bpaulina25/CBE3300B/Images/sd card.JPG

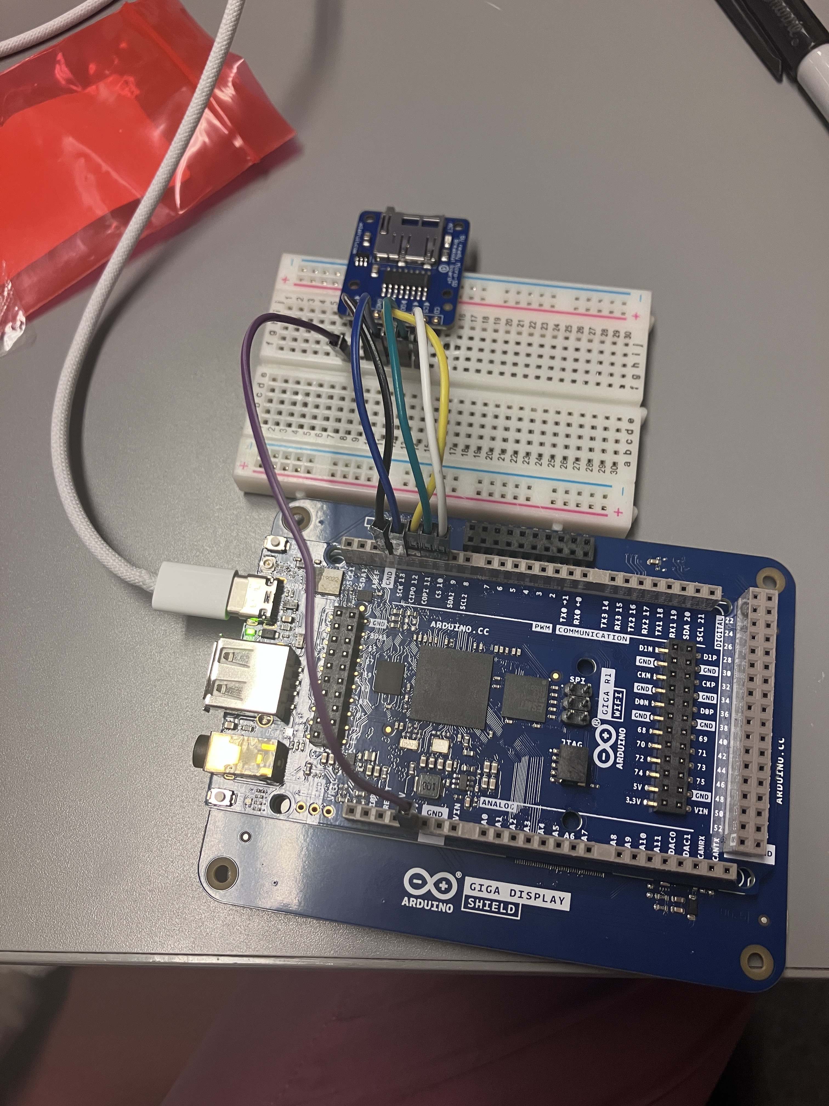
Images/sd card.JPG
