bpaulina25/CBE3300B/Images/io_rodeostat.png

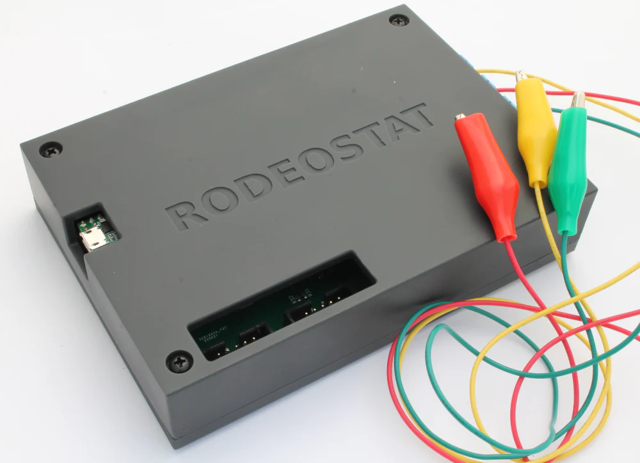
Images/io_rodeostat.png
