bpaulina25/CBE3300B/README.md

# CBE3300B
Glucometer Project with Paulina Bargallo, Kayla Powell and Theertha Vannemreddy
