bpaulina25/CBE3300B/proposal.html

Project Proposal: Potentiostat-Based Glucometer

Introduction

The increasing prevalence of diabetes necessitates the development of reliable, accessible, and accurate glucometers. Traditional glucometers utilize enzyme-modified electrodes for electrochemical glucose detection. This project aims to develop a low-cost, potentiostat-based glucometer prototype that employs cyclic voltammetry for glucose quantification. The system will be validated against standard glucose solutions to ensure accuracy and reproducibility, paving the way for further refinements in electrochemical biosensing technology.

Objectives

- Construct a potentiostat capable of performing cyclic voltammetry.
- Adapt the potentiostat for glucose detection using enzyme-modified electrodes.
- Validate the prototype by calibrating it with standard glucose solutions.
- Identify and address limitations to improve future iterations.

Materials and Components

Hardware:

- IO Rodeostat ($240, already purchased)
- Adapters from IO Rodeostat (https://blog.iorodeo.com/zp_hypervalue_rodeostat_adapter/) for screen-printed electrodes (optional, depending on AimsStrip compatibility)
- Power Supply (Compatible with Adafruit ItsyBitsy M4, (Adafruit board guide (https://www.adafruit.com/product/2124)))
  - Battery backpack (Adafruit LiIon/LiPoly Backpack (https://www.adafruit.com/product/2124)) can debug w/ USB connection switch to LiIon/LiPoly when disconnected
- Display Screen Options:
  - Arduino Display
    - Sold out in Arduino USA (https://store-usa.arduino.cc/products/giga-display-shield), but available in eBay (https://www.ebay.com/itm/156329309170?chn=ps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) for $55 and in Arduino Europe (https://store.arduino.cc/products/giga-display-shield)
    - This is the option we like the most, we hope to be able to not only store information and display date, time, user and previous readings as well as average of readings but to also control with it the whole device.
    - How to program GitHub page. (https://github.com/upiir/arduino_giga_display_shield)
  - Display compatible (https://www.adafruit.com/product/4200?ref=blog.iorodeo.com) with IO Rodeostat - $35
    - This is our second option, we like the availability of the buttons as we hope to do the same as with the Arduino Display, we want to make sure both are compatible with ItsyBitsy and it is on our level to program. Has been used before by IO Rodeo in a colorimeter product (https://blog.iorodeo.com/open-colorimeter-product-guide/), this are the electronics (https://blog.iorodeo.com/open-colorimeter-electronics/).
  - Adafruit Display (https://www.digikey.com/en/products/detail/adafruit-industries-llc/3531/7364307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)- $24, Uses Raspberry Pi
    - We are not sure we want to go this route so it is possible we do no longer consider it.
- Microcontroller: Adafruit ItsyBitsy M4 (https://www.adafruit.com/product/3800) ($15, consider purchasing three in case of failure)

Calibration and Testing:

- Glucose test strips (AimsStrip (https://www.germainelabs.com/product/aimstrip-plus-blood-glucose-test-strips-50-box/), Amazon (https://www.amazon.com/AimStrip-37350-Blood-Glucose-Strips/dp/B07J5P9GXG?s=industrial), $15.15 for 50 strips)
  - AimsStrip glucose test strips contain glucose oxidase, therefore we will be basing our reactions on this enzyme.
- d-Glucose stock solution (250 g/L in PBS)
- Phosphate-buffered saline (PBS) for dilutions
- Calibration concentrations: 10–200 mg/dL

Benchmark fasting blood glucose ranges:

- Normal: 70–100 mg/dL
- Low: <70 mg/dL
- High: >125 mg/dL

Software and Tools:

- Arduino IDE for waveform generation and data acquisition
- Processing script for real-time data visualization
- Excel/Matlab for calibration curve fitting and data analysis

Methodology

- Calibration:
  - Prepare glucose solutions (10–200 mg/dL) for calibration.
  - Conduct cyclic voltammetry scans, analyzing oxidation current peaks for correlation with glucose concentration.
  - Discard initial unstable scans and average subsequent scans for consistency.
- Testing and Validation:
  - Evaluate performance using glucose standards within physiologically relevant ranges.
  - Compare prototype readings to known glucose concentrations to assess accuracy and linearity.
  - Identify potential anomalies such as saturation at high concentrations and address underlying causes (e.g., mixing issues, electrode kinetics limitations).
- Data Analysis:
  - Generate calibration curves based on the Randles-Sevcik equation.
  - Analyze deviations at high glucose concentrations and adjust scan parameters accordingly.

Engineering Design Considerations

- Signal Stability: Noise reduction through optimized resistor selection and scan rates.
- User Interface: Develop an intuitive interface for user-friendly data retrieval and analysis.
- Power Supply: Assess battery-operated vs. external power options for portable use.

Concepts for Future Improvements

- Error Analysis: Improve accuracy by refining calibration and eliminating systematic biases.
- Data Storage and User Profiles: Implement onboard memory to track readings over time.
- Integration with Display Modules: Consider LCD or LED screens for real-time data visualization.

Minimum Viable Product (MVP)

- Functional potentiostat using IO Rodeostat.
- Basic glucose detection with standard calibration.
- Python-based data output (no external display required).
- Single-user operation without long-term data storage.
- Acceptable margin of error (15%) per industry standards.

Main Goals

- Develop a user-friendly glucose meter.
- Achieve industry-standard error margins.
- Optimize calibration to meet ISO specifications.
- Store and analyze user data for long-term tracking.
- Incorporate date/time functionality for better monitoring.

Engineering Design for a Glucose Meter

- Design Considerations: Designing a glucose meter from scratch requires attention to accuracy, durability, user-friendliness, and manufacturability. The device must reliably measure blood glucose levels while maintaining portability and ease of use for patients. Key design elements include:
  - Electrochemical Sensor Integration: Ensuring that the electrodes and sensor interface with the testing strip effectively.
  - Microcontroller & Signal Processing: Selecting a suitable microcontroller to process sensor data and display readings accurately.
  - User Interface & Display: Designing an intuitive LCD or OLED display for easy readability of results.
  - Power Efficiency: Optimizing battery life to allow prolonged usage without frequent recharging.
  - Button and Screen Design: Ensuring that the buttons are tactile, responsive, and easy to press. The screen should have a backlight for readability in low-light conditions and use a high-contrast display to accommodate users with visual impairments
  - Test Strip Insertion Space: Designing a dedicated, easy-to-access slot for test strips that aligns properly with the sensor to ensure accurate readings. The space should be durable, resistant to contamination, and facilitate effortless insertion and removal of strips.
- Material Selection:
  - Housing Material: The enclosure must be lightweight, durable, and resistant to chemical exposure. Common materials include:
    - ABS Plastic: Offers strength, impact resistance, and ease of manufacturing.
    - Polycarbonate (PC): Provides excellent optical clarity for display covers and high impact resistance.
    - Medical-Grade Silicone: Used for areas requiring flexibility and skin contact.
    - Sensor Material: Electrodes are typically made from gold, platinum, or carbon-based materials to ensure accurate glucose readings.
    - Transparent Cover: If an optical component is used, acrylic or
- 3D Printing Considerations:To prototype and manufacture certain components, 3D printing is a cost-effective and efficient approach. Considerations include:
  - Printing Technology:
  - Fused Deposition Modeling (FDM): Suitable for quick and low-cost prototyping using PLA or ABS.
  - Stereolithography (SLA): Provides high precision and smooth surfaces, ideal for detailed housing parts.
- Material Compatibility:
  - PLA: Easy to print but lacks high durability. (This is what we use in CBE lab)
  - Resin (SLA): High precision but more fragile than thermoplastics. (Can use FormLabs Printers in Towne or Biotech Commons)
- Structural Integrity:
  - Wall thickness should be optimized to balance durability and weight.
  - Snap-fit or screw-based designs should be tested for assembly efficiency. (Still debating which would be the best).
- Surface Finishing:
  - Smoothing processes like acetone vapor treatment (for ABS) or UV curing (for SLA) improve aesthetic and functional properties.s.

Prototyping and Testing

- Drop and Stress Testing: Ensures durability for everyday use.
- Chemical Resistance Testing: Verifies material stability against blood and cleaning agents.
- User Ergonomics Evaluation: Assesses handling ease, readability, and button placement.

Review of glucometer electrochemical reactions

Glucose monitoring devices are currently dominated by electrochemically mediated analytical techniques. The main governing reaction in glucose concentration determination is the aerobic oxidation of glucose, shown below. The chemistry involved is the oxidation of glucose via the enzyme glucose oxidase (GOx) to produce glucono-d-lactone (GNL). The dissolved oxygen re-oxidizes the enzyme, producing hydrogen peroxide in molar equivalence.

α-D-glucose⇌β-D-glucose (1)

β-D-glucose+O2→GOx

\text{H}_{2}\text{O}_{2} + \text{GNL} (2)

H2O2 --> 2H+ + O2 + 2e- (3)

O2 + 4e- --> 2O2- (4)

A relatively high stock concentration (250 g/L) of b-D-glucose in PBS will be used for preparing dilutions of experimental blood serum simulant. If preparation of fresh glucose is needed, time for anomeric equilibrium be taken into account (1), as glucose oxidase (GOx) is only active on the b-D glucose conformation (2). Otherwise measurements will not be reliable due to fluctuating b-D-glucose concentration.

As shown in (2), the amount of dissolved molecular oxygen present and H2O2 produced is in molar equivalence with the glucose, and electroanalytical methods can be employed to measure the current generated at the electrode and determine glucose concentration in whole blood/blood serum.

H2O2 is an electrochemically active species, and is oxidized on the test strip (usually a Pt anode) in the form of (3). Monitoring the amount of oxygen consumed via Clark electrodes (4) can also allow for glucose concentration determination using selective oxygen reduction.

These preceding reactions represent the enzyme interactions of first-generation blood sugar test strips. However, the limitations of this approach are mainly due to oxygen’s poor performance as an electron acceptor due to its reduced solubility of oxygen in blood and susceptibility to oxygen deficit [add link]. Additionally, measurement of H2O2 concentration via amperometric methods tended to require high operating potentials for sufficient selectivity [add link]. Thus, mediator ions were integrated into second-generation glucose biosensors to more accurately measure glucose concentration-dependent current generation. A proposed mechanism is seen below [add link]:

Fe(III)cat-GOxRED + (5)

In these test strips, the enzyme is re-oxidized by the mediator. Then, the mediator reagent is re-oxidized at the anode surface, generating an electrical current proportional to the concentration of glucose. Ferrous compounds like ferrocenes and ferricyanide are a common selection due to high stability in both oxidized and reduced states.

The test strips (AimStrip Plus Mini) used in our system are second-generation glucose biosensors that use potassium ferricyanide as the mediator, according to the SDS [add link]. Therefore, determination of electrode-type is not needed and amperometric analysis for the ferri/ferrocyanide couple can be implemented in our glucometer.

Chronoamperometry:

In chronoamperometry, a step potential is applied to induce the Faradaic electron transfer that can be characterized by existing equations for diffusion controlled current generation. Prior to step potential, the potential of WE is held as a value that produces no faradaic electron transfers. Then a sufficiently lower/higher potential is applied to produce the desired reduction/oxidation of the target species.

The Cottrell equation, below, will be used to construct the glucometer calibration curve between current and glucose concentration.

i = (6)

In the case of ferri/ferrocyanide (assuming sat'd Ag/AgCl RE), the minimum step potential can be estimated from available data. The equilibrium potential for the RE vs. SHE is +0.197 V [link] and for ferri/ferrocyanide it is +0.356 V [link]. It follows that E = + 0.356 V - 0.197 V to give an estimated 160 mV as the expected step potential minimum. This will need to be experimentally confirmed.

Trials will be conducted over a range of step potential values to assess a suitable positive applied potential to generate a diffusion controlled current (on an i vs t1/2 plot, according to (6)). Calculations can be done to determine an upper limit to the step potential to avoid interference from other oxidizable species in the analyte. Lag time will also need to be experimentally determined to avoid initial double layer charging not modeled in (6).

The glucometer will apply the step potential and record the relevant current value, apply the calibration equation, and output the generated glucose concentration calculation.

Current market glucometer product design features:

Typical features of glucometers currently available include, but are not limited to, the following:

Copy over list

Preliminary firmware development:

- 1. Power on/off buttons and time-out response
- 2. CA analyte detection/initiation
- 3. Memory - Date/Time syncing and daily averaging or ~100 past readings storage
- 4. Display configuration

This project provides a foundation for developing a practical, low-cost glucometer with future scalability for enhanced features such as wireless data transfer and cloud integration. The prototype will be iteratively improved based on testing outcomes and user feedback to meet clinical standards.
