bpaulina25/CBE3300B/Presentations/Potentiostat-Based Glucometer Proposal.pdf

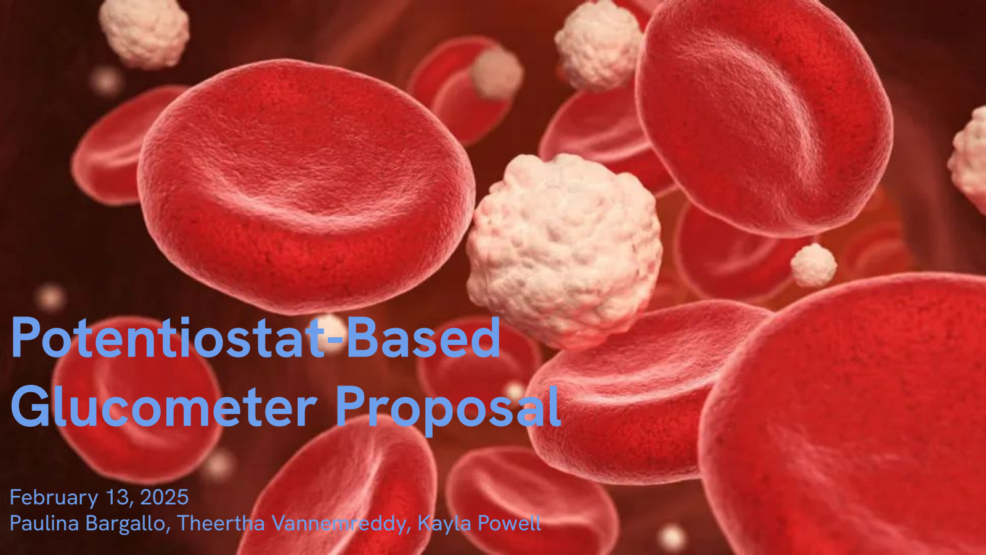
[picture p3: page 1]

# Potentiostat-Based Glucometer Proposal

## February 13, 2025 Paulina Bargallo, Theertha Vannemreddy, Kayla Powell

Overview

The increasing prevalence of diabetes necessitates the development of reliable, accessible, and accurate glucometers. This project aims to develop a low-cost, potentiostat-based glucometer prototype that employs amperometry for glucose quantification. The system will be validated against standard glucose solutions to ensure accuracy and reproducibility, paving the way for further refinements in electrochemical biosensing

technology.

# Project Overview

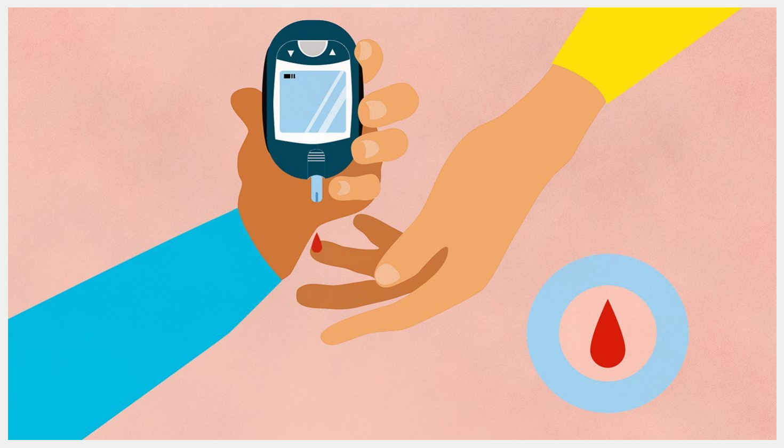
[picture p4: figure]

# Project Objectives

Objectives

Design an easy-to-use, durable, portable glucometer.

Ensure compatibility between all components through various prototyping stages.

Development of sufficient redox-mediated calibration between glucose concentration and electrochemically produced measurement appropriate for instrumentation.

Final product performs similarly compared to current available second generation glucometer.

Calibration

Hardware
development

User-friendly
design

Experimental
validation

01

02

03

04

# Working Schedule

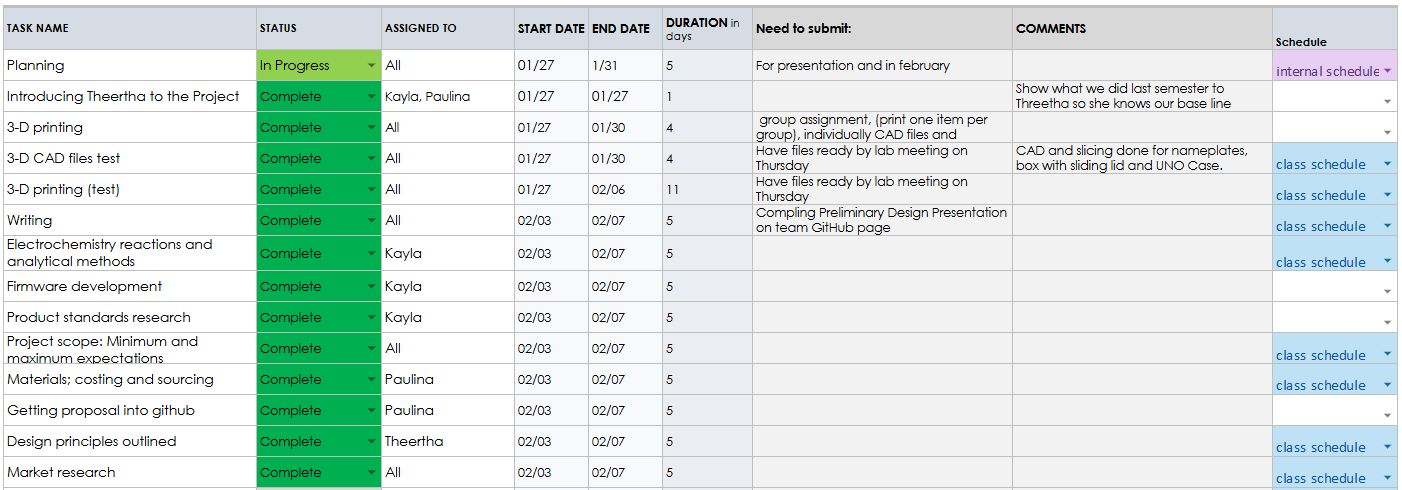
[picture p5: figure]

# Materials and Components

Proposal

### - AimsStrip Plus Mini glucose test strips ($15.15 for 50 strips)

### - d-Glucose stock solution (250 g/L in PBS)

### - PBS for dilution preparation

### - IO Rodeostat

### - Accompanying Adafruit ItsyBitsy Board (MC)

### - Electrode wire connector (adjusted for test strips) and shim

### - Adafruit Li Battery Backpack

### - Arduino Display (available on eBay for $55)

### - IO Rodeostat-compatible display ($35)

### - Adafruit Display ($24)

Calibration and Testing | Hardware Components | Display Screen Options

### Purchased, Needs to be purchased

Sold out in: Arduino USA, (https://store-usa.arduino.cc/products/giga-display-shield)
Available: in eBay (https://www.ebay.com/itm/156329309170?chn=ps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) for $55 In Arduino Europe (https://store.arduino.cc/products/giga-display-shield)

## Arduino Display

# TO BUY (please & Thank you) :

Adafruit | ItsyBitsy | M4 (https://www.adafruit.com/product/3800) | - | $15,
purchasing 2

## Microcontroller

AimsStrip, (https://www.germainelabs.com/product/aimstrip-plus-blood-glucose-test-strips-50-box/) Amazon, (https://www.amazon.com/AimStrip-37350-Blood-Glucose-Strips/dp/B07J5P9GXG?s=industrial) $15.15 for 50 strips

(as many as possible Dr. Huff can by for us at once)

## Glucose Test Strip

## PBS

For this experiment so we do not use CBE 4800.

## Battery Backpack

Adafruit LiIon/LiPoly Backpack (https://www.adafruit.com/product/2124)

$4.80 (buy 3)

# AimStrip Plus Glucose Meter

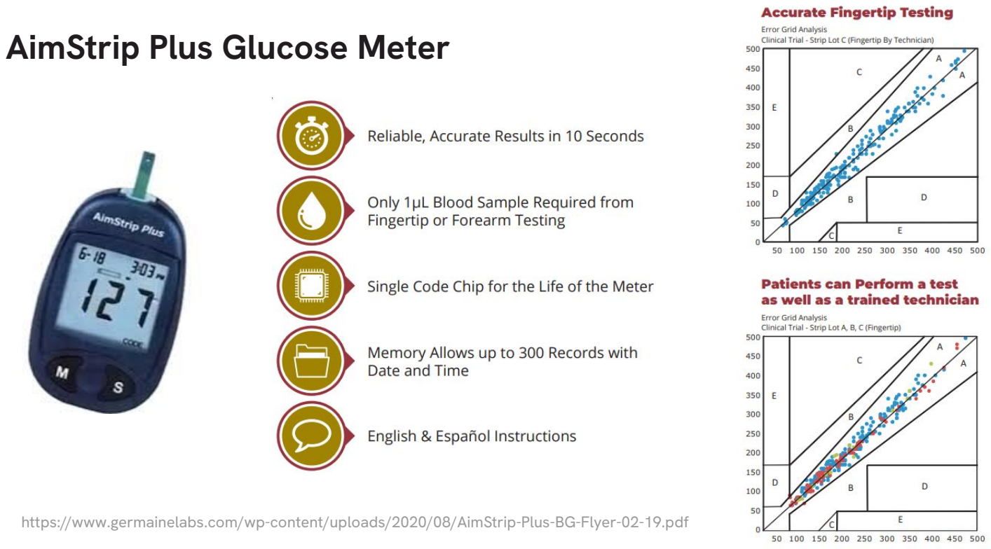
[picture p6: page 7]

https://www.germainelabs.com/wp-content/uploads/2020/08/AimStrip-Plus-BG-Flyer-02-19.pdf

### - Primary reaction is aerobic oxidation of glucose with glucose oxidase (GOx)

### - Redox-mediated electron transfer introduced to improve efficiency, accuracy

### - AimStrip Plus Strips

– | GOx/FAD
– | Ferri/ferrocyanide mediator
– | 10 sec response time

# Electrochemical Reactions in Glucometers

Chemistry

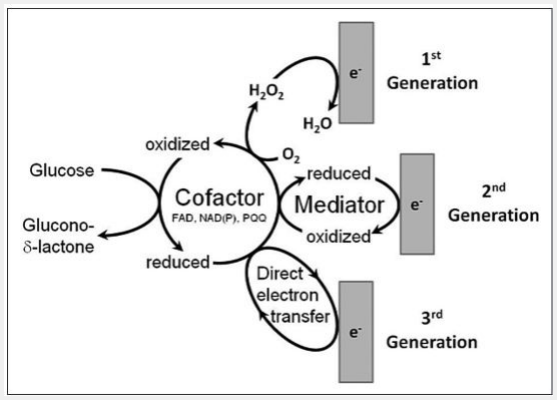
[picture p7: figure]

https://doi.org/10.1177/193229681100500507

# Analytical Methods

Chemistry

### - Amperometric analysis

### - Experimentally determine

### – Appropriate step potential for selective oxidation of Fe(II) back to Fe(III)

### – Lag time (steady-state)

### - Get linear calibration between current and concentration from Cottrell equation:

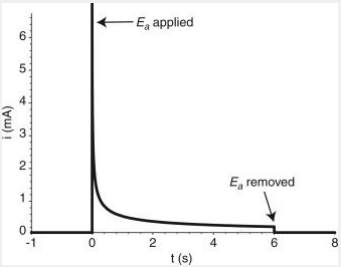
[picture p8: figure]

https://doi.org/10.1016/B978-0-12-802993-0.00004-6

# Engineering Design Considerations

Design

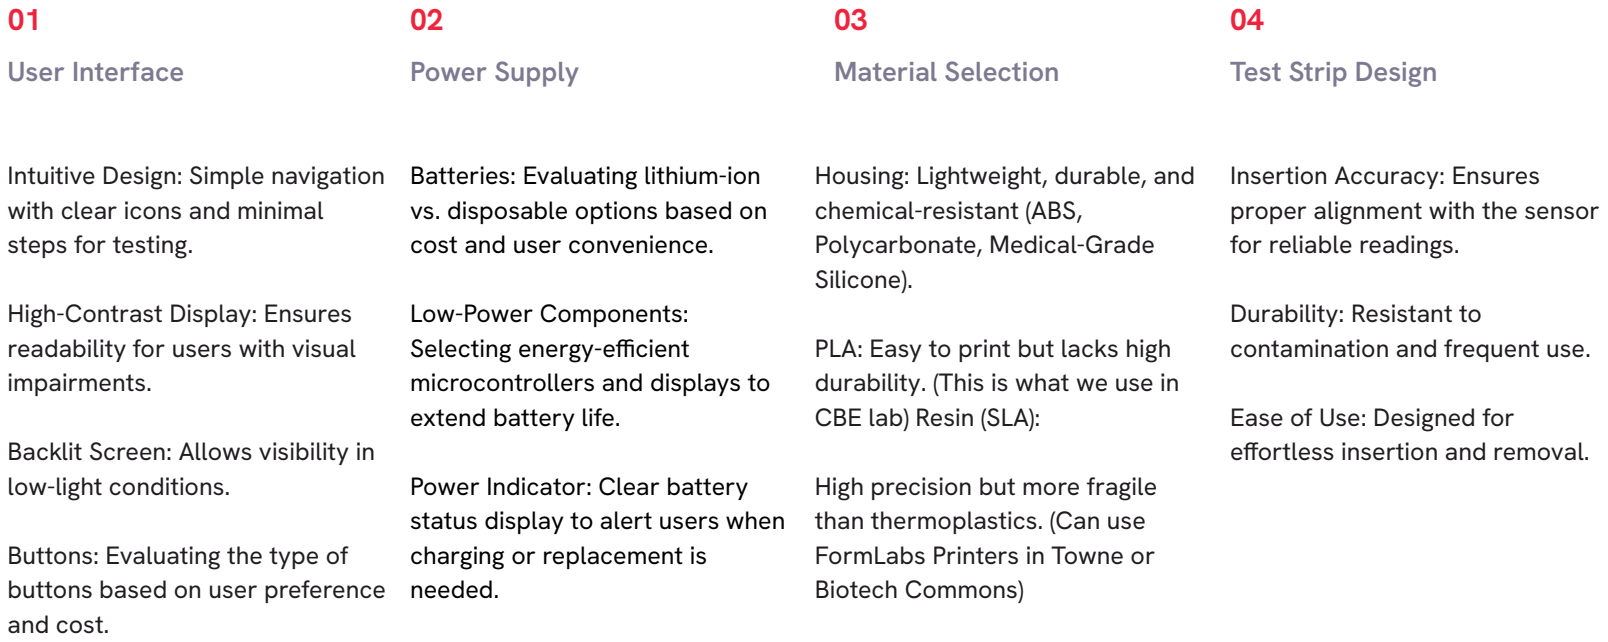
[picture p9: figure]
Intuitive Design: Simple navigation with clear icons and minimal steps for testing.; High-Contrast Display: Ensures readability for users with visual impairments.; Backlit Screen: Allows visibility in low-light conditions.; Buttons: Evaluating the type of buttons based on user preference and cost.; Batteries: Evaluating lithium-ion vs. disposable options based on cost and user convenience.; Low-Power Components: Selecting energy-efficient microcontrollers and displays to extend battery life.; Power Indicator: Clear battery status display to alert users when charging or replacement is needed.; User Interface; Power Supply; Housing: Lightweight, durable, and chemical-resistant (ABS, Polycarbonate, Medical-Grade Silicone).; PLA: Easy to print but lacks high durability. (This is what we use in CBE lab) Resin (SLA):; High precision but more fragile than thermoplastics. (Can use FormLabs Printers in Towne or Biotech Commons); Material Selection; Insertion Accuracy: Ensures proper alignment with the sensor for reliable readings.; Durability: Resistant to contamination and frequent use.; Ease of Use: Designed for effortless insertion and removal.; Test Strip Design

### 3D Printing

# Prototyping and Testing

Engineering Design

Material Testing | Chemical Resistance Testing | User Ergonomics Evaluation

Utilize fused deposition
modeling (FDM) for quick and low-cost prototyping using PLA or ABS materials. This approach allows for rapid iterations in design before final production.
Conduct drop and stress testing to ensure durability for everyday use. The goal is to verify that the device withstands typical handling and potential impacts. | Verify the material stability against blood and cleaning agents. This ensures that the device remains functional and safe for users in real-world scenarios. | Assess handling ease, readability, and button placement to ensure the glucometer is user-friendly and accessible, particularly for users with visual impairments.

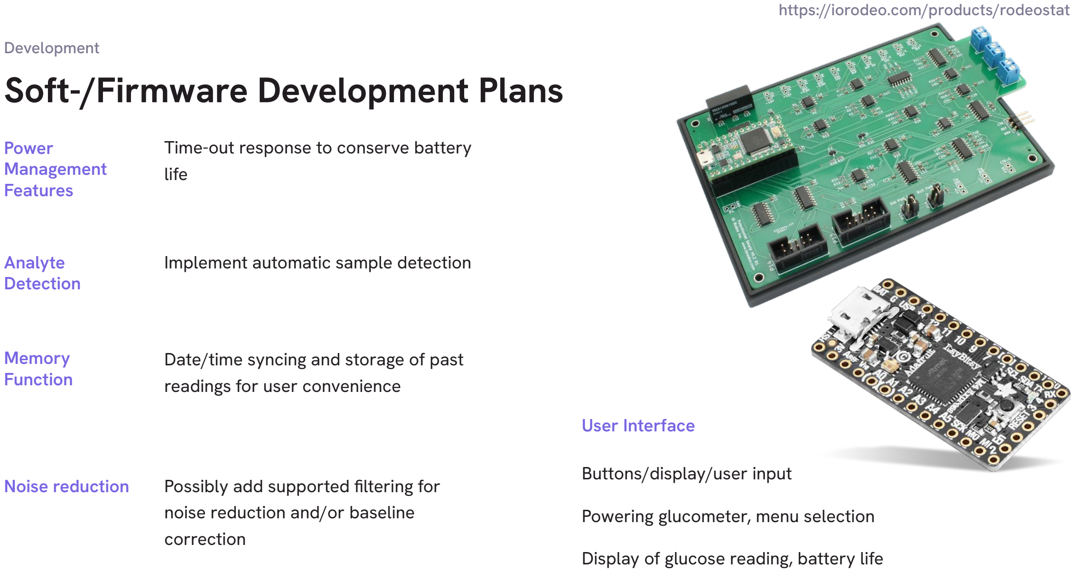
[picture p10: figure]
Soft-/Firmware Development Plans; Development; Time-out response to conserve battery life; Implement automatic sample detection; Power Management Features; Analyte Detection; Memory Function; Date/time syncing and storage of past readings for user convenience; Noise reduction; User Interface; Possibly add supported filtering for noise reduction and/or baseline correction; Buttons/display/user input; Powering glucometer, menu selection; https://iorodeo.com/products/rodeostat

Display of glucose reading, battery life

### - Functional potentiostat

using IO Rodeostat.

### - Basic glucose detection

with standard calibration.

### - Python-based data output (no external display

required).

### - Single-user operation without long-term data

storage.

### - Acceptable margin of error

### - User-friendly design and ISO-approved accuracy - Store and analyze user

data for long-term tracking.

### - Incorporate date/time functionality for better

monitoring.

### - Portable and durable design

Minimum Viable Product | Main Goals

# Project Scope

### - Product build - Test strip connection to potentiostat

### - Durability

### - Calibration - Large error - Batch-to-batch test strip inconsistencies

### - Firmware integration - User-friendly interface

## Expected Challenges

Summary

# Conclusion and Next Steps

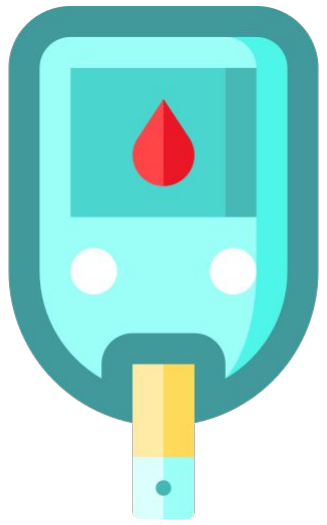
[picture p11: figure]

## Develop a user-friendly, low-cost, amperometric-based glucometer to enhance ease of glucose monitoring for

individuals with diabetes.

## Next steps include:

## - Familiarization with IO Rodeostat and completed calibration function - Design parts purchases - Outline for prototype-circuit and continued research into circuit design

# Thank you! Questions?

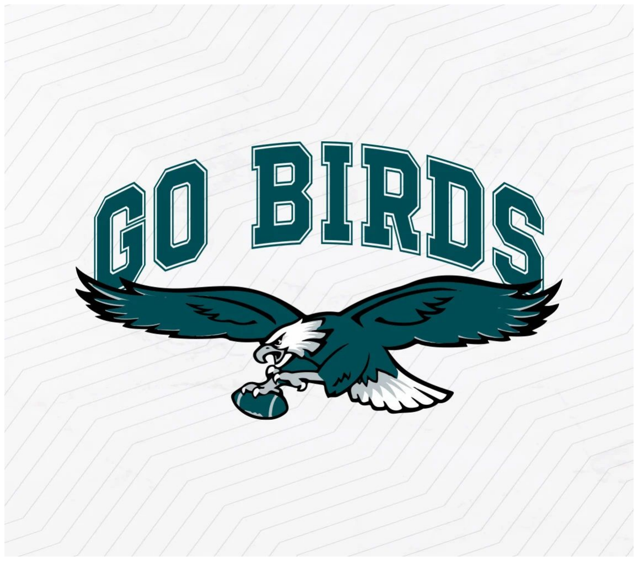
[picture p12: figure]
