bpaulina25/CBE3300B/Presentations/SweeTech_ Glucometer_Development Plan.pdf

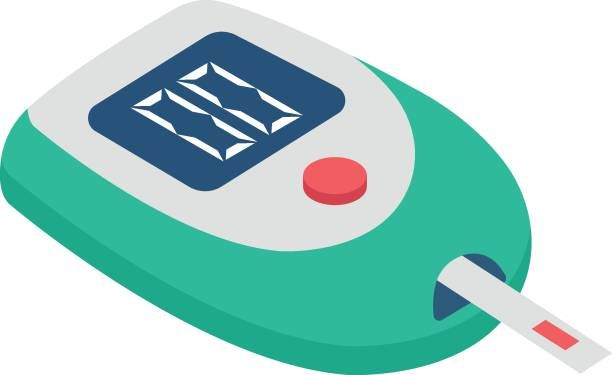
[picture p13: figure]

SweeTech

# Glucometer Development

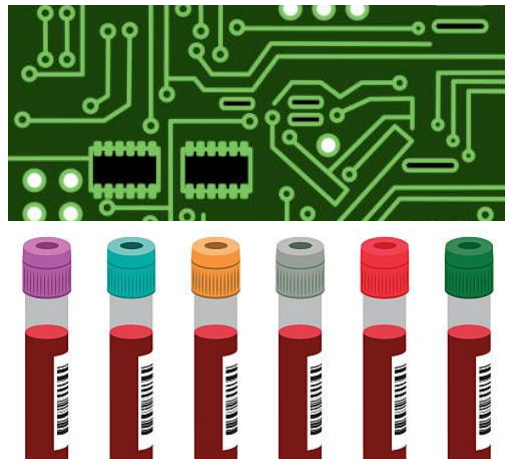
[picture p14: figure]

# Plan

Contributor
Kayla Powell, Paulina Bargallo, Theertha Vannemreddy

# How do glucometers work?

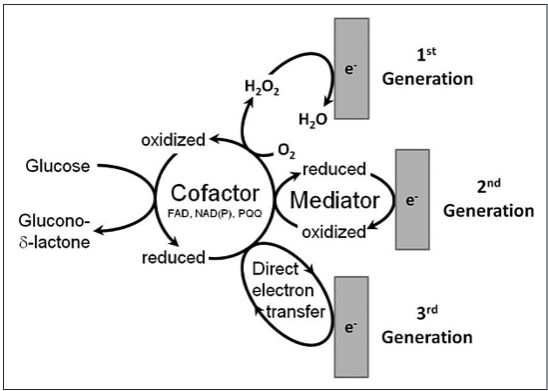
[picture p15: figure]

- Electrochemical reactions occur on biosensor
- Glucose oxidase (GOx) is most common enzyme
- Primary reaction is aerobic oxidation of glucose with GOx/FAD
– O2

electron acceptor
– Concentration determined via O2 consumption or H2O2

generation
– Challenges: O2

mass transfer limitations
and high overpotentials
- Redox-mediated electron transfer introduced to improve efficiency, accuracy
- Advancements in nanotechnology allow for direct electron transfer to support continuous glucose level monitoring

# AimStrip® Plus Glucose Meter and Strips

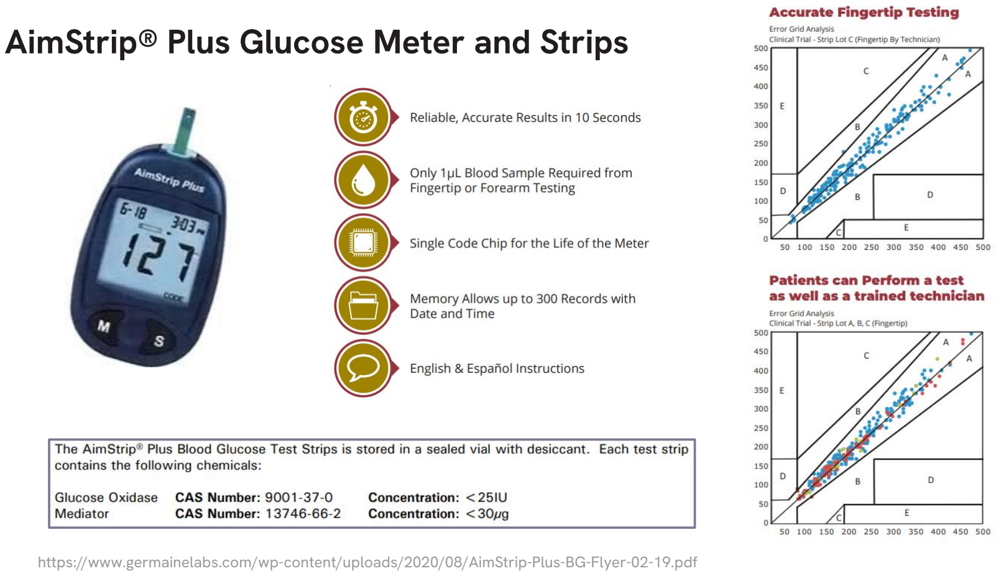
[picture p16: page 3]

https://www.germainelabs.com/wp-content/uploads/2020/08/AimStrip-Plus-BG-Flyer-02-19.pdf

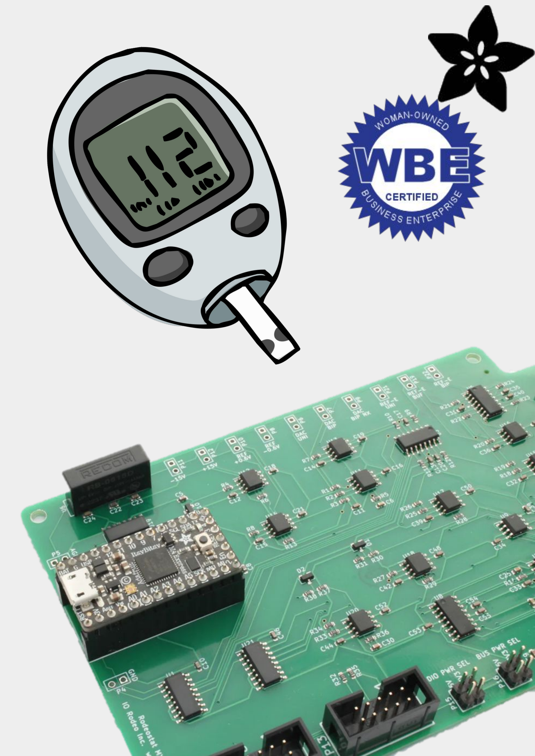
[picture p17: figure]

# Our glucometer design

- IO Rodeostat supported amperometry
– Digitally-controlled
– Selective oxidation of mediator for calibration
- Hardware selection
– Adafruit ItsyBitsy M4 MCU
- Internal and serial flash memory
- Supports python + USB debugging
- 12-bit ADC and general in/output pins
– Arduino GIGA Display Shield/R1 WiFi
- High resolution and touch-screen function
- SPI communication with board
- Python support for integration
- 3D printing
– Biosensor connection
– Sturdy design for practical use and secure integration of components

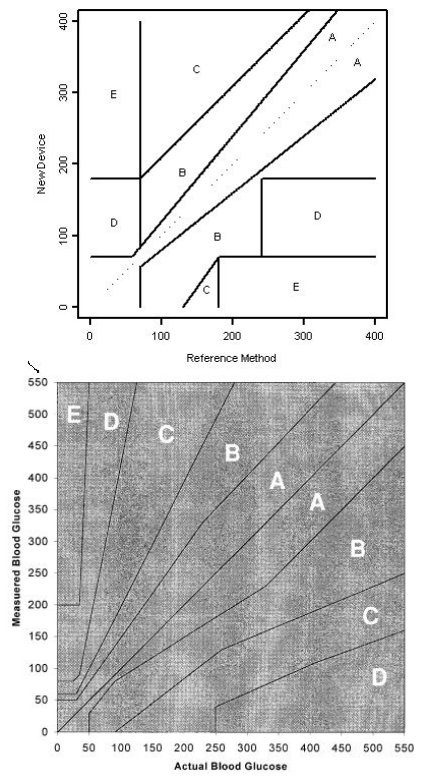
[picture p18: figure]

# Accuracy standards

- ISO 15197:2013 (user performance evaluation for 95% of samples) – <100 mg/dL: ± 15 mg/dL
– ≥100 mg/dL: ± 15% error
- Error grids (right)
– Clarke Error Grid (top)
– Consensus Error Grid for Type II diabetes (bottom)
- Advanced grid following the development of glucose monitoring devices
- FDA/EU requirements
- WHO recommendations
– Testing range of 30-400 mg/dL
– ISO compliance
– 99% results fall within zones A/B of Consensus Error Grid – Technical and performance specifications are detailed (https://www.who.int/publications/m/item/who-technical-specifications-for-blood-glucose-meter) for enzymatic with amperometric detection formats

# Diabetes and glucose monitoring market trends

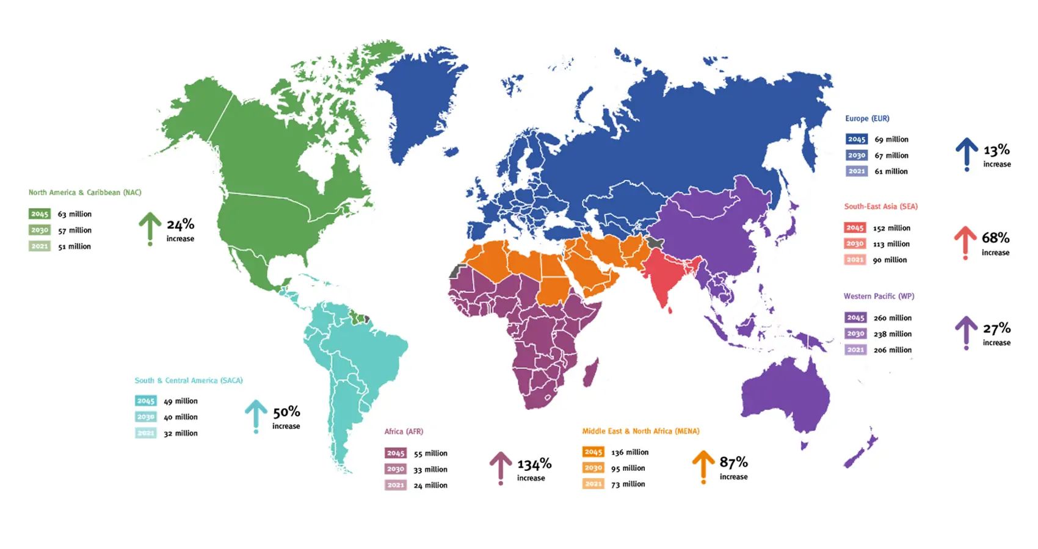
[picture p19: figure]

# Diabetes and glucose monitoring market trends

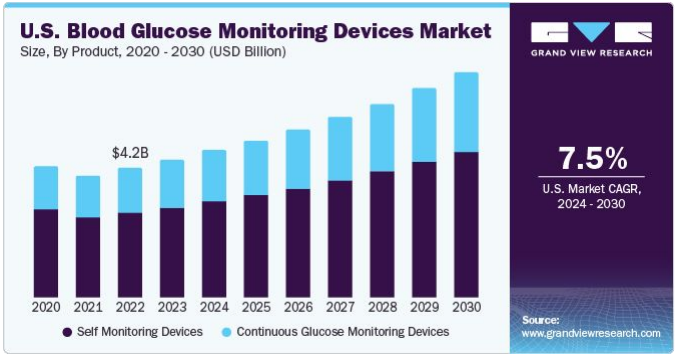
[picture p20: figure]

# Diabetes and glucose monitoring market trends

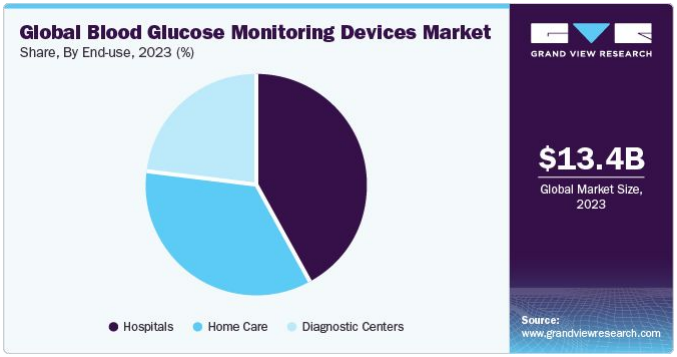
[picture p21: figure]

# Competitive evaluation

- Key features of industry self-monitoring devices – $20-100 per glucometer
– Portable and compact
– Some devices have continuous monitoring.
– Most of cost is test strip (glucometers often included for free) – Waterproof
- Features of SweeTech glucometer
– $240 potentiostat
– $137 display components
– Much more sophisticated potentiostat than is needed for glucometer function – Not commercially competitive; better for learning and research purposes
– Not portable due to large size. Not compact
– Does not have live monitoring features.

## SWOT analysis

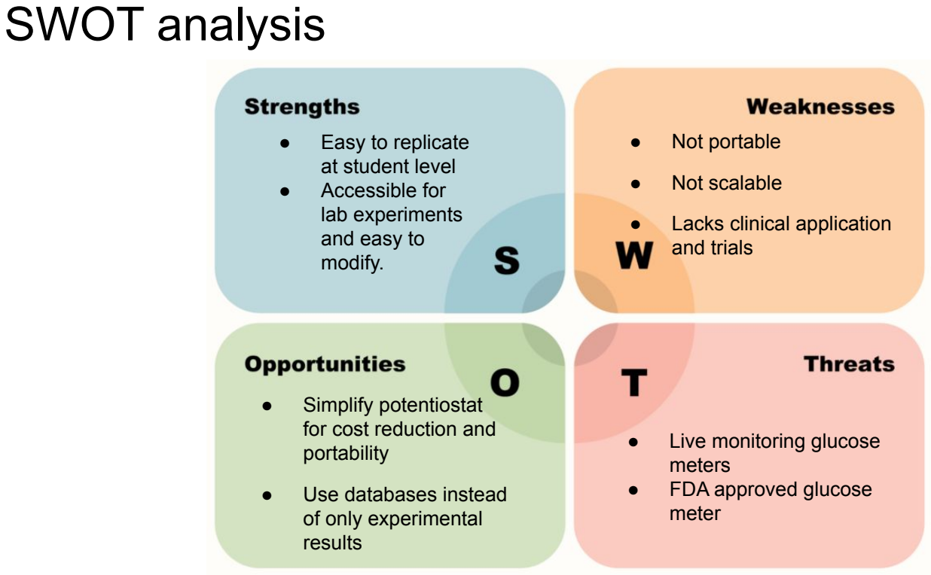
[picture p22: page 10]

- Easy to replicate
at student level
- Accessible for
lab experiments
and easy to
modify.
- Not portable
- Not scalable
- Lacks clinical application and trials
- Simplify potentiostat
for cost reduction and
portability
- Use databases instead
of only experimental
results
- Live monitoring glucose
meters
- FDA approved glucose
meter

## Project timeline and deliverables

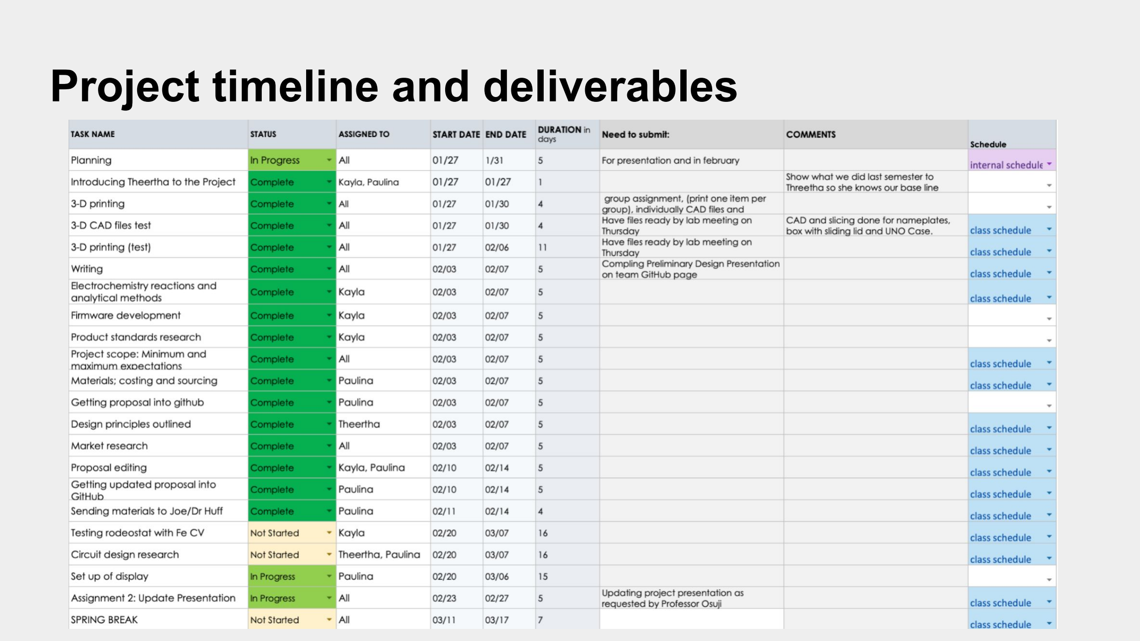
[picture p23: page 11]
