bpaulina25/CBE3300B/final_resources/Final_Demo_Glucometer.pdf

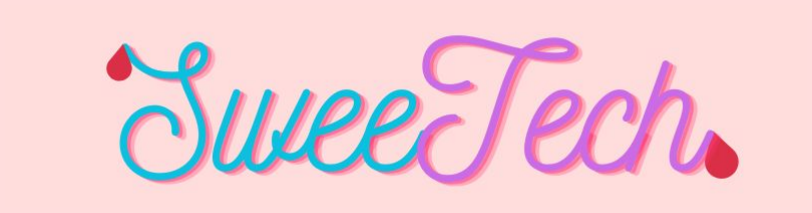
[picture p24: figure]

## Potentiostat-based Glucometer Development

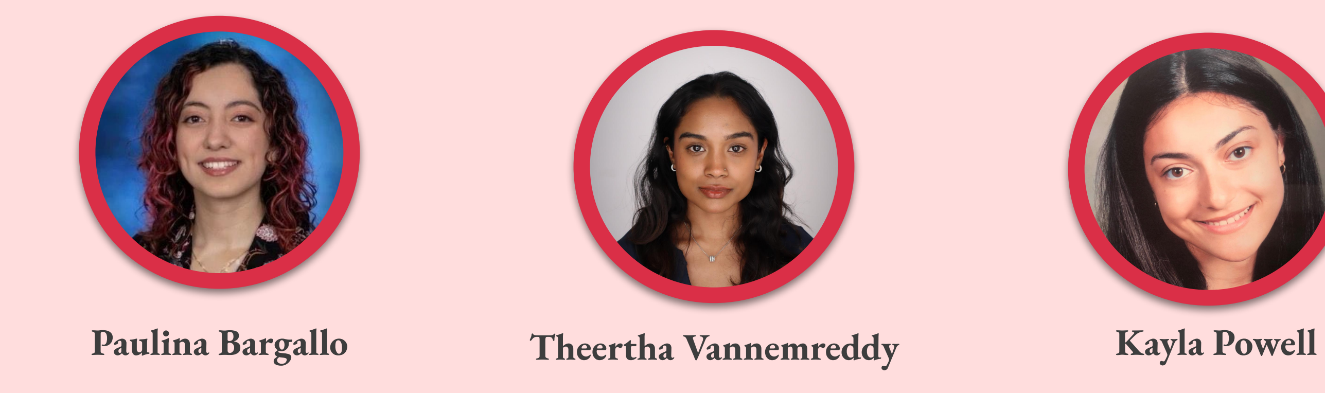
[picture p25: figure]
Paulina Bargallo; Theertha Vannemreddy; Kayla Powell
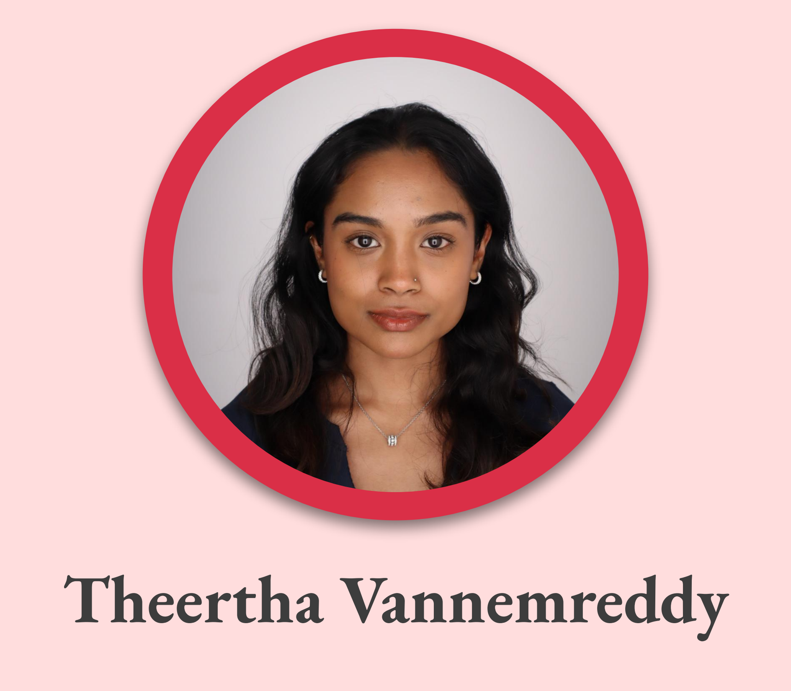
[picture p26: figure]
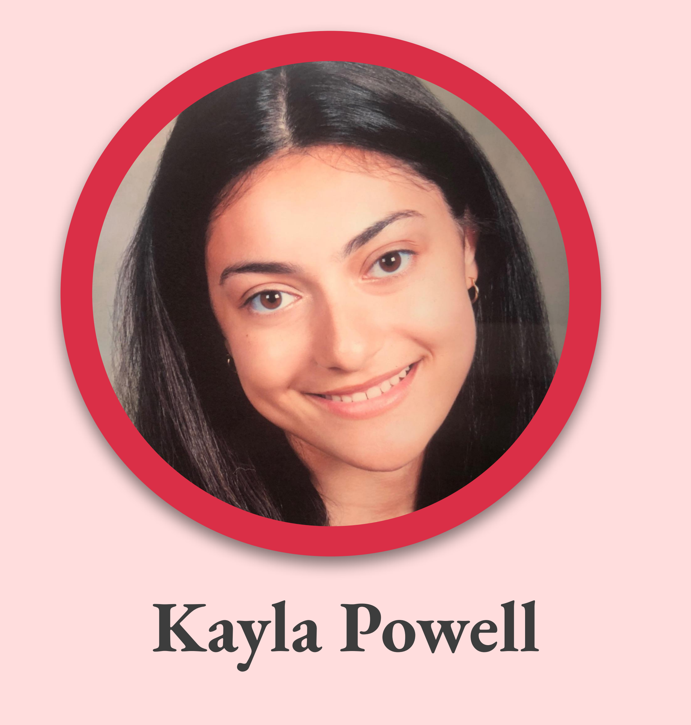
[picture p27: figure]

## CBE 3300 - Final Demonstration May 7th, 2025

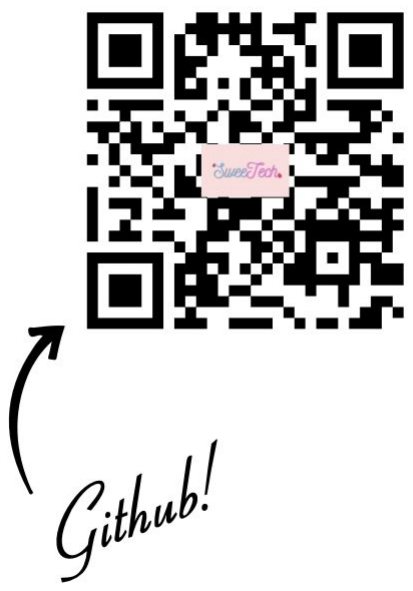
[picture p28: figure]

2

# Github Page

# Project Overview

With diabetes on the rise, this project develops a potentiostat-based glucometer using amperometry for glucose detection.

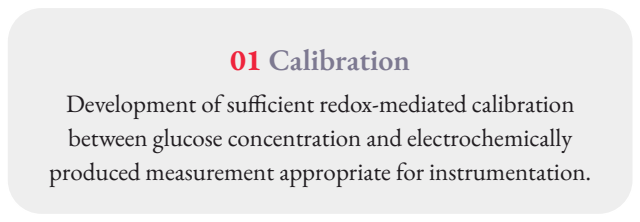
[picture p29: figure]
01 Calibration; Development of sufficient redox-mediated calibration between glucose concentration and electrochemically produced measurement appropriate for instrumentation.
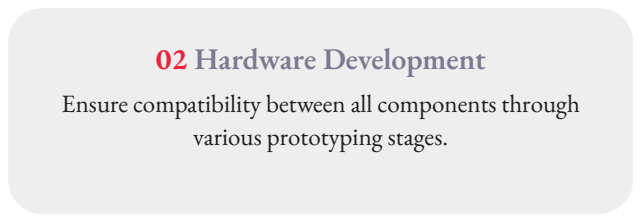
[picture p30: figure]
02 Hardware Development; various prototyping stages.

Ensure compatibility between all components through

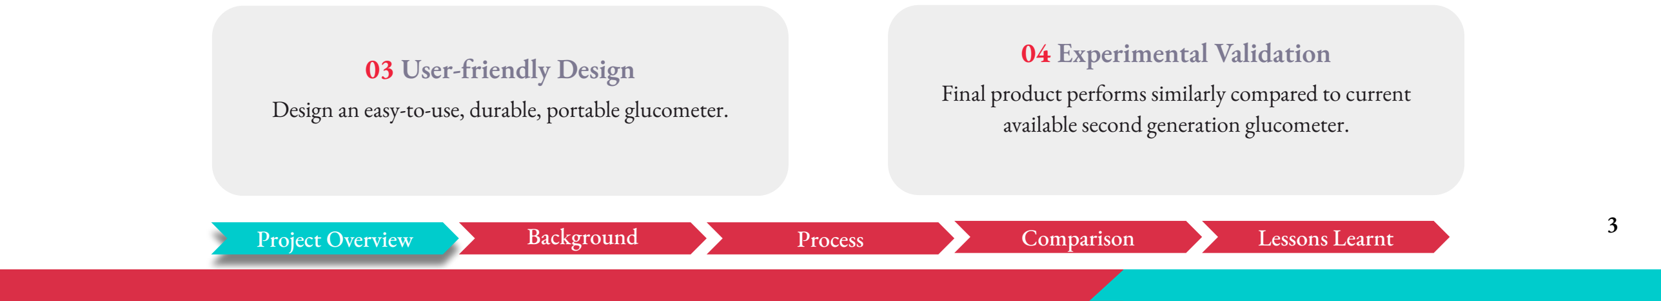
[picture p31: figure]
Project Overview; Background; Process; Comparison; Lessons Learnt; 03 User-friendly Design; 04 Experimental Validation; available second generation glucometer.

Design an easy-to-use, durable, portable glucometer.

Final product performs similarly compared to current

# Our Background

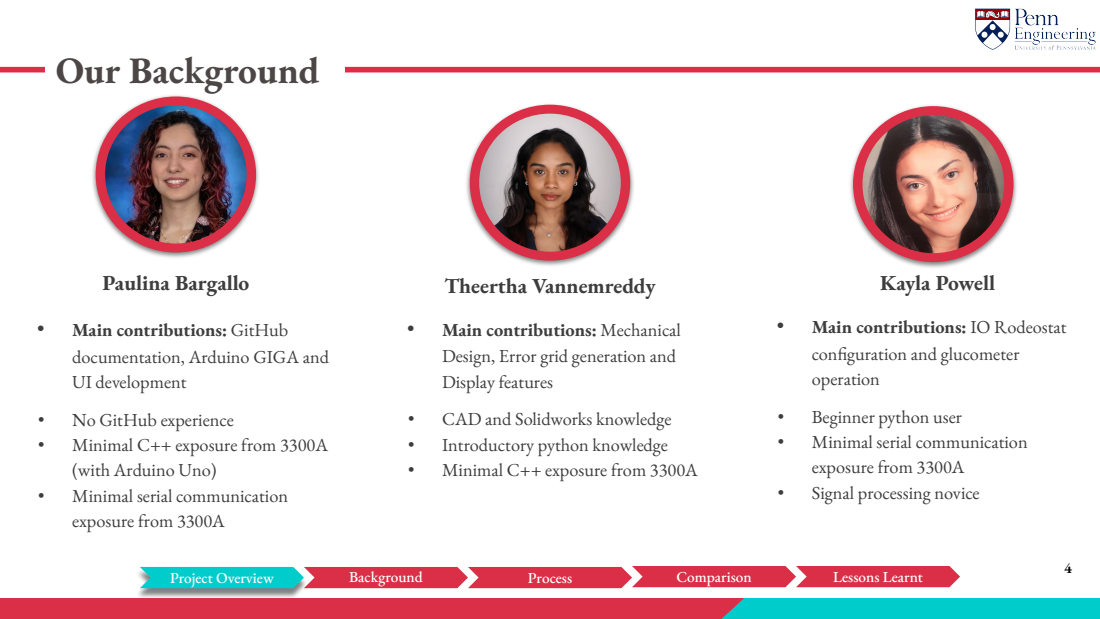
[picture p32: page 4]
Project Overview; Background; Process; Comparison; Lessons Learnt; Paulina Bargallo; Theertha Vannemreddy; Kayla Powell

• Main contributions: GitHub
documentation, Arduino GIGA and
UI development
• No GitHub experience
• Minimal C++ exposure from 3300A
(with Arduino Uno)
• Minimal serial communication
exposure from 3300A

• Main contributions: Mechanical
Design, Error grid generation and
Display features
• CAD and Solidworks knowledge
• Introductory python knowledge

• Main contributions: IO Rodeostat
configuration and glucometer
operation
• Beginner python user
• Signal processing novice

5

Project Overview | Background | Process | Comparison | Lessons Learnt

# Background

# Market Landscape

537M

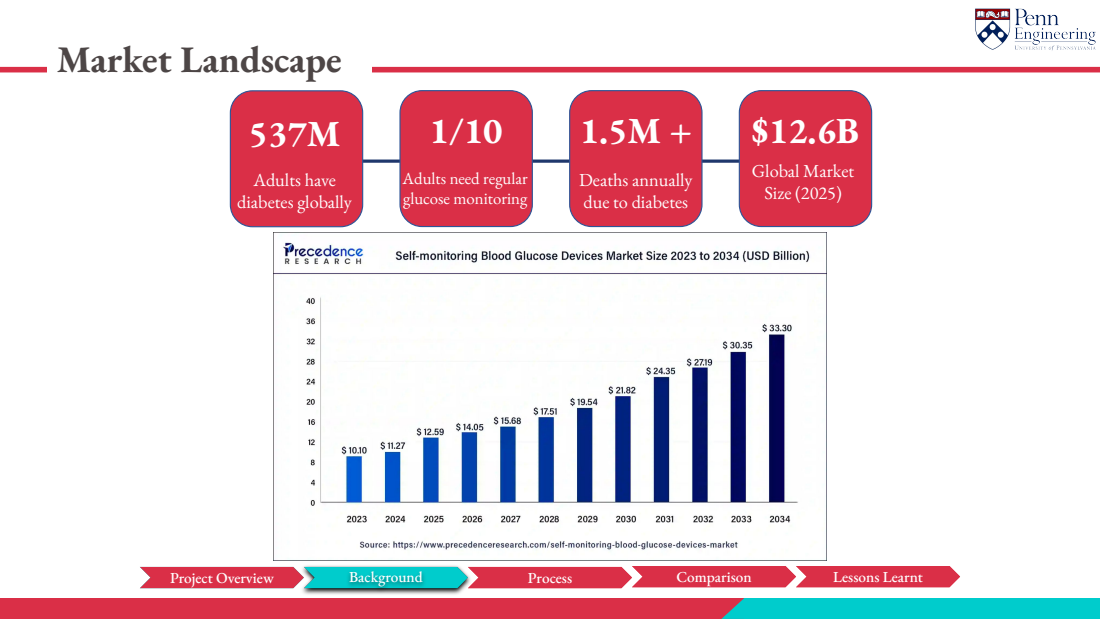
[picture p33: page 6]
Adults have diabetes globally; Global Market Size (2025); Project Overview; Background; Process; Comparison; Lessons Learnt

Adults need regular
glucose monitoring

Deaths annually
due to diabetes

# Global glucose monitoring market trends

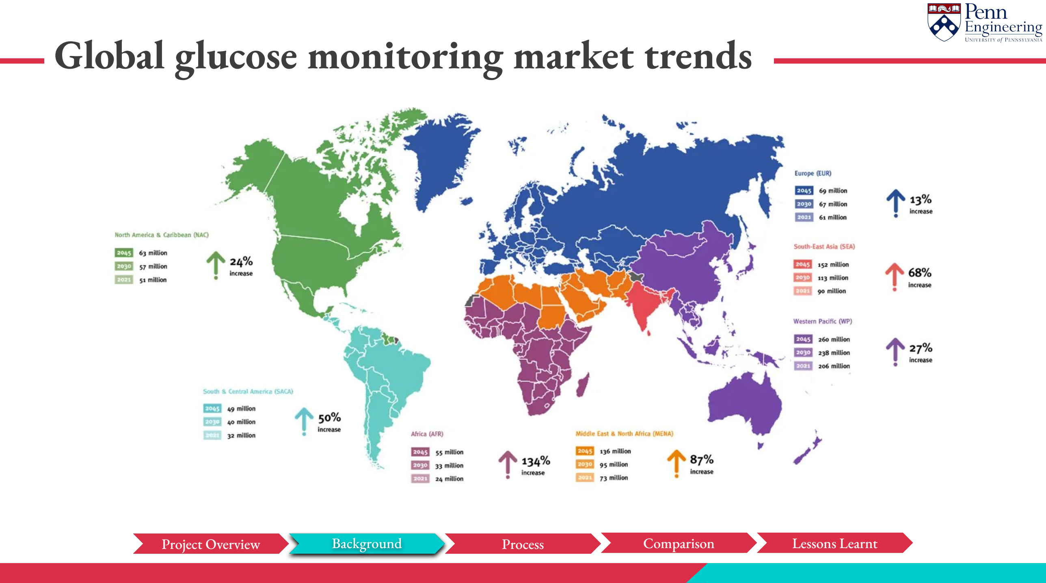
[picture p34: page 7]

Project Overview | Background | Process | Comparison | Lessons Learnt

# How do glucometers work?

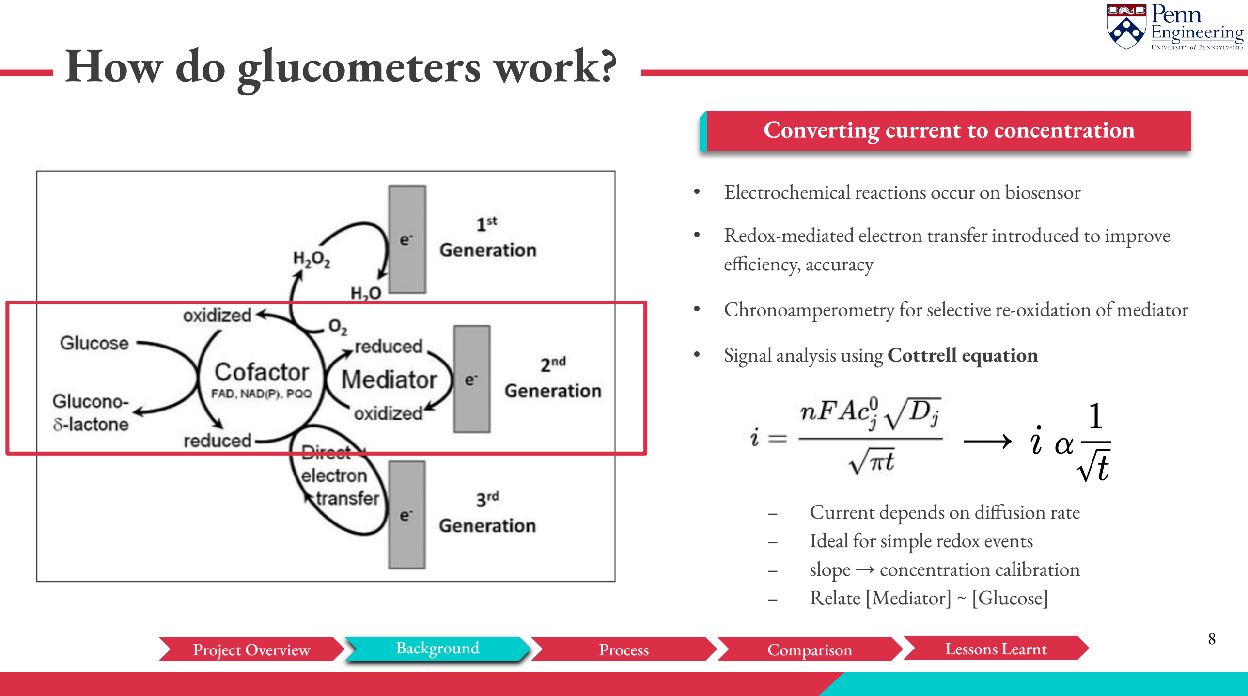
[picture p35: page 8]

Converting current to concentration

- Electrochemical reactions occur on biosensor
- Redox-mediated electron transfer introduced to improve efficiency, accuracy
- Chronoamperometry for selective re-oxidation of mediator
- Signal analysis using Cottrell equation

– Current depends on diffusion rate – Ideal for simple redox events
– slope → concentration calibration – Relate [Mediator] ~ [Glucose]
Problem | Background | Model | Conclusion | 8
Project Overview | Background | Process | Comparison | Lessons Learnt

# AimStrip® Plus Glucose Meter and Strips

## Diagnostic

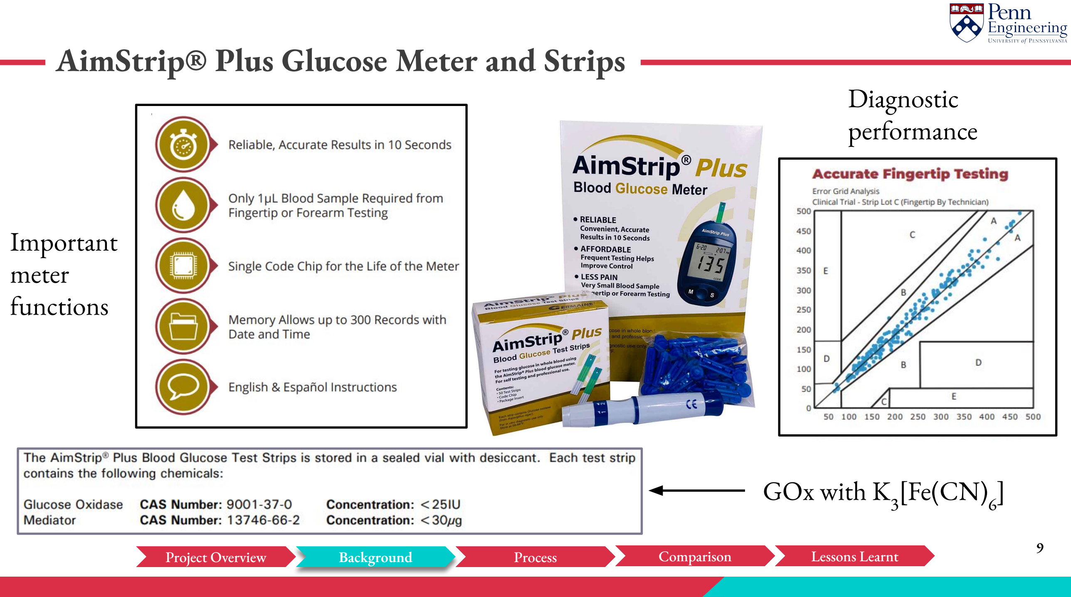
[picture p36: page 9]

9
Problem Problem | Background | Process Model | Comparison Feasibility Feasibility | Lessons Learnt Conclusion Conclusion
| Background
Project Overview | | Process | Comparison | Lessons Learnt

## performance

## GOx with K3

## [Fe(CN)6

]

## Important meter functions

10 Project Overview | Background | Process | Comparison | Lessons Learnt

# Development Process

# Analysis Flowchart

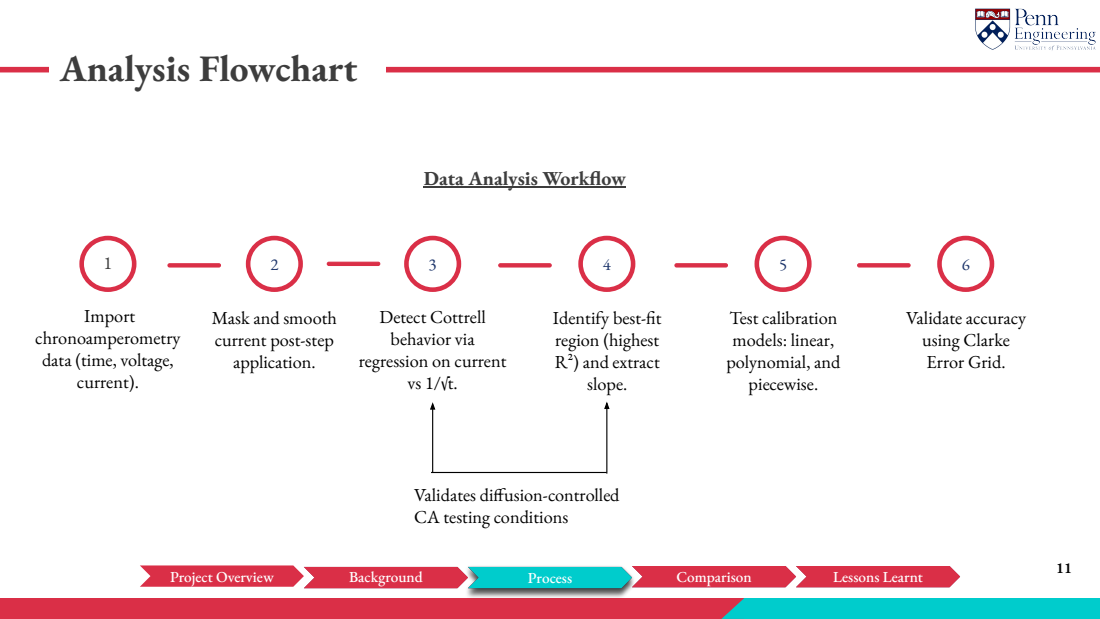
[picture p37: page 11]
11 Project Overview; Background Background; Process Model; Comparison Feasibility; Lessons Learnt Conclusion; Test calibration models: linear, polynomial, and piecewise.; Validate accuracy using Clarke Error Grid.

Data Analysis Workflow

Import
chronoamperometry
data (time, voltage,
current).

Mask and smooth
current post-step
application.

Detect Cottrell
behavior via
regression on current

Identify best-fit
region (highest
R²) and extract
slope.

Validates diffusion-controlled
CA testing conditions

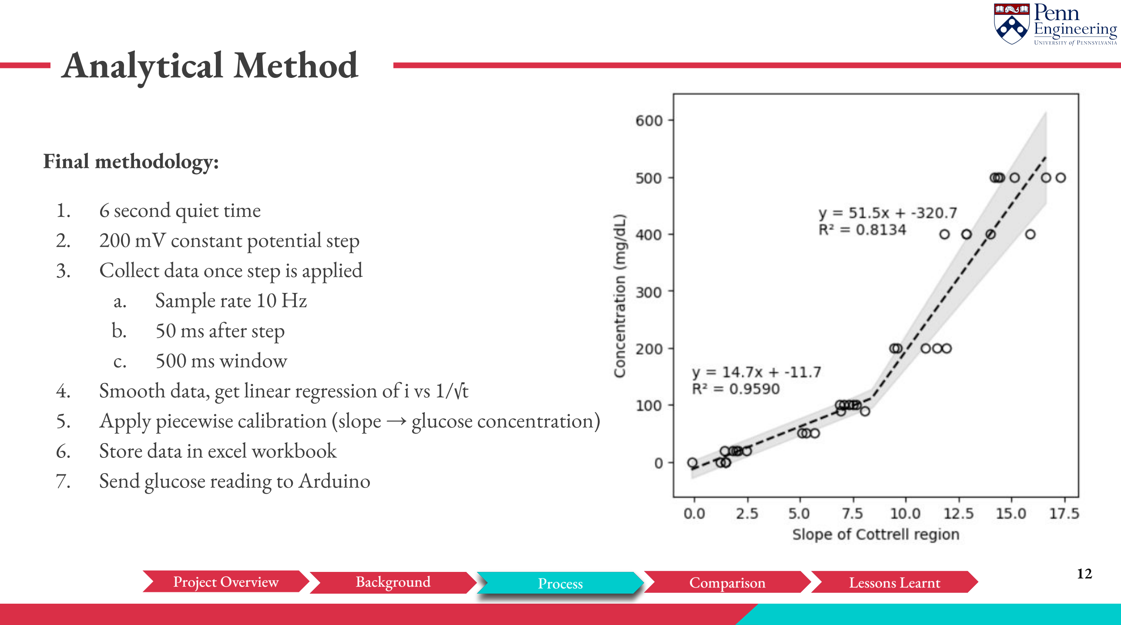
[picture p38: figure]
Analytical Method; 12 Project Overview; Background Background; Process Model; Comparison Feasibility; Lessons Learnt Conclusion; Final methodology:; 1. 6 second quiet time 2. 200 mV constant potential step 3. Collect data once step is applied a. Sample rate 10 Hz b. 50 ms after step c. 500 ms window; 6. Store data in excel workbook 7. Send glucose reading to Arduino

4. Smooth data, get linear regression of i vs 1/√t
5. Apply piecewise calibration (slope → glucose concentration)

# Accuracy Standards

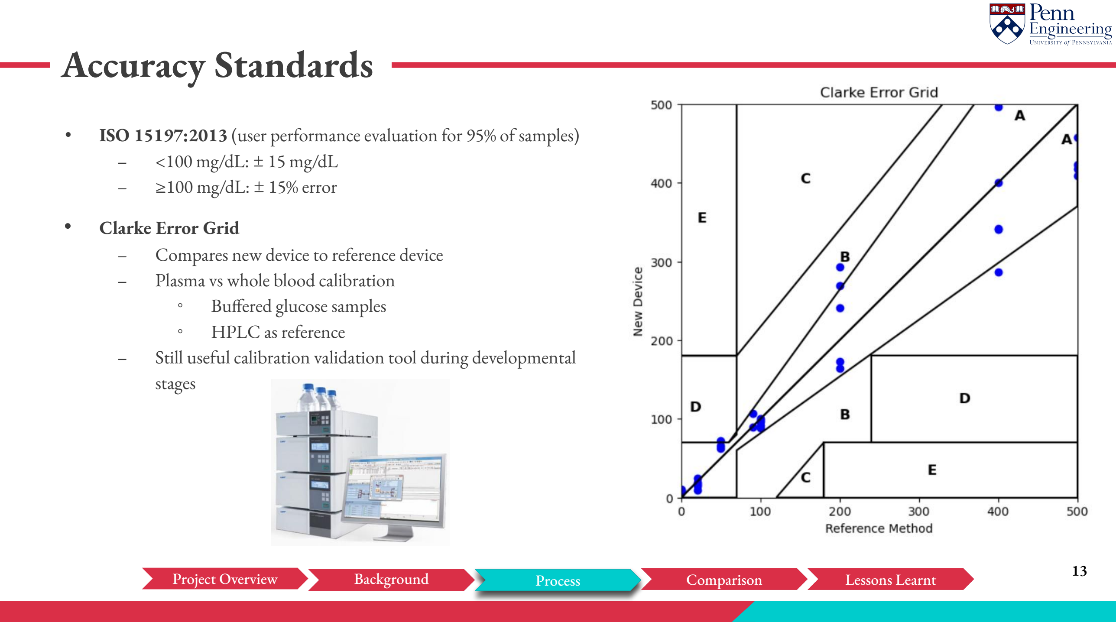
[picture p39: page 13]

13 Project Overview | Background Background | Process Model | Comparison Feasibility | Lessons Learnt Conclusion
- ISO 15197:2013 (user performance evaluation for 95% of samples) – <100 mg/dL: ± 15 mg/dL
– ≥100 mg/dL: ± 15% error
- Clarke Error Grid
– Compares new device to reference device – Plasma vs whole blood calibration
- Buffered glucose samples
- HPLC as reference
– Still useful calibration validation tool during developmental stages

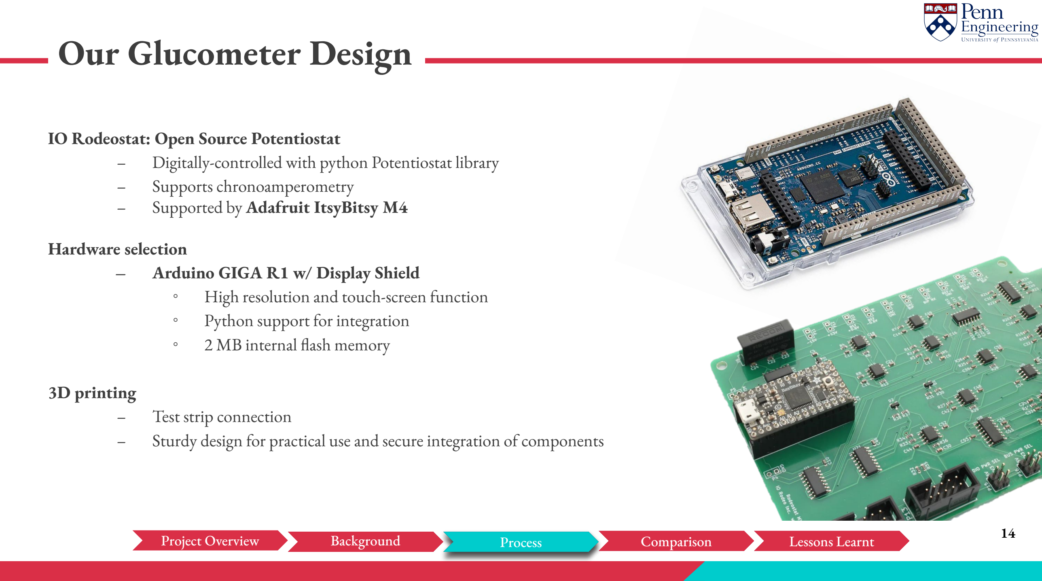
[picture p40: figure]
Our Glucometer Design; IO Rodeostat: Open Source Potentiostat; – Supports chronoamperometry – Supported by Adafruit ItsyBitsy M4; Hardware selection – Arduino GIGA R1 w/ Display Shield; ◦ Python support for integration ◦ 2 MB internal flash memory; 3D printing; Test strip connection; Project Overview; Background Background; Process Model; Comparison Feasibility; Lessons Learnt Conclusion

– Digitally-controlled with python Potentiostat library

- High resolution and touch-screen function

– Sturdy design for practical use and secure integration of components

# Arduino GIGA Set-up

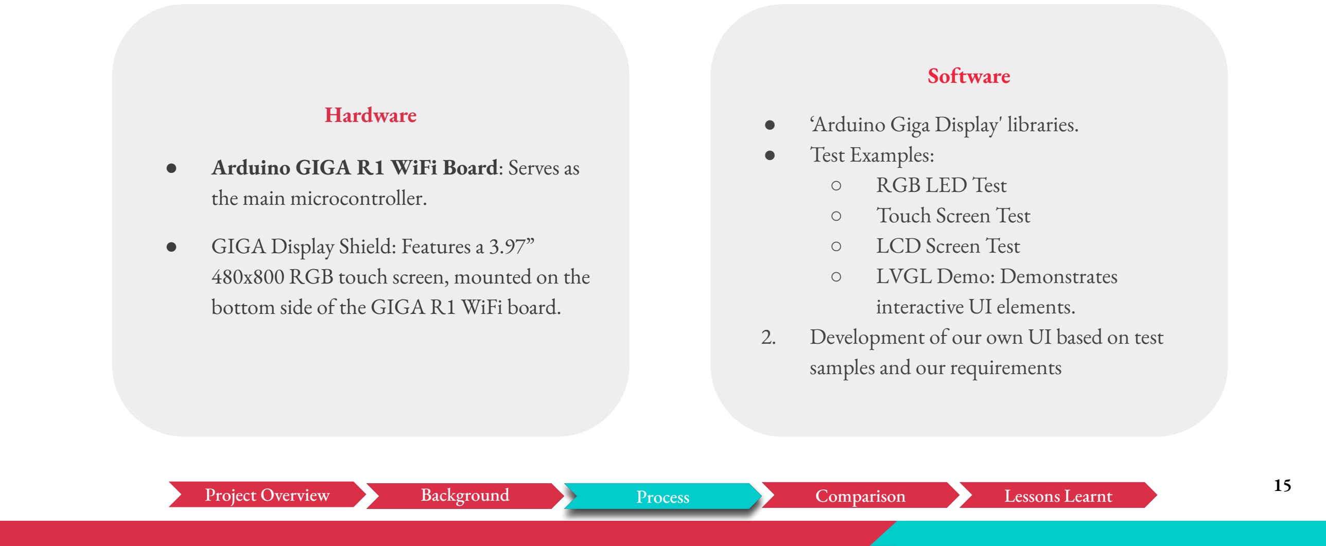
[picture p41: figure]
15 Project Overview; Background Background; Process Model; Comparison Feasibility; Lessons Learnt Conclusion; Software; ● ‘Arduino Giga Display' libraries. ● Test Examples: ○ RGB LED Test ○ Touch Screen Test ○ LCD Screen Test ○ LVGL Demo: Demonstrates interactive UI elements.; samples and our requirements; Hardware; ● Arduino GIGA R1 WiFi Board: Serves as the main microcontroller.; ● GIGA Display Shield: Features a 3.97”; bottom side of the GIGA R1 WiFi board.

2. Development of our own UI based on test

480x800 RGB touch screen, mounted on the

# Display Logic Overview

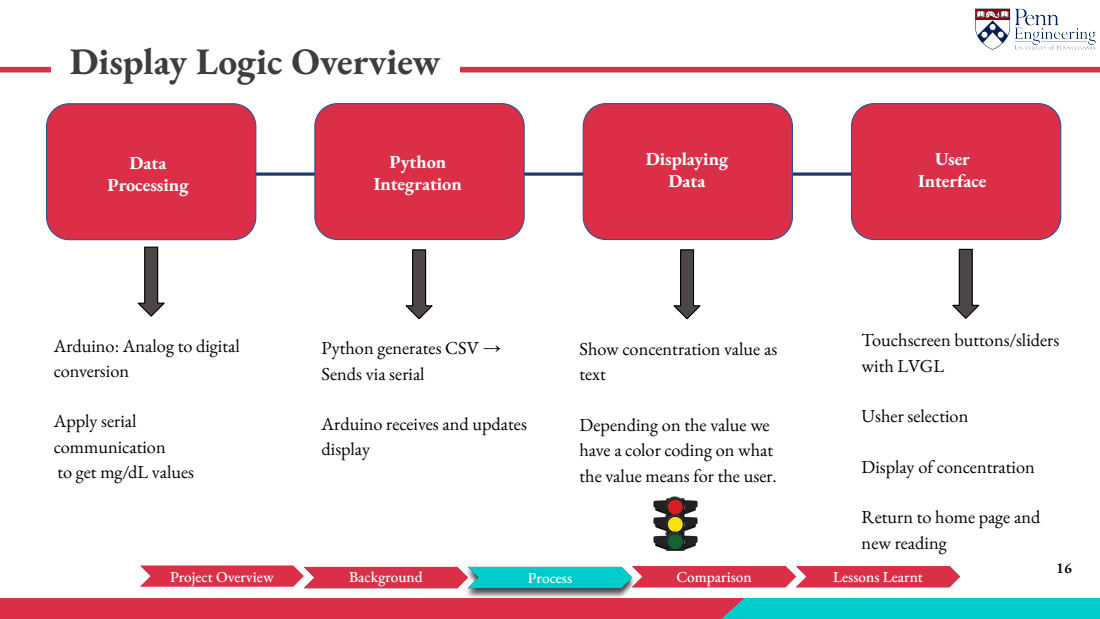
[picture p42: page 16]
16 Project Overview; Background Background; Process Model; Comparison Feasibility; Lessons Learnt Conclusion; Data Processing; User Interface; Python Integration; Displaying Data; Usher selection

Arduino: Analog to digital
conversion

Python generates CSV →
Sends via serial

Touchscreen buttons/sliders
with LVGL

Show concentration value as
text

Apply serial
communication
to get mg/dL values

Arduino receives and updates
display

Depending on the value we
have a color coding on what
the value means for the user.

Display of concentration

Return to home page and
new reading

## Concentration Display

The glucose concentration display dynamically changes color based on real-time sensor readings. The background of the info panel adjusts to reflect risk zones, providing immediate visual feedback to the user:

- Under 70 mg/dL: Hypoglycemia warning (yellow)
- 70–99 mg/dL: Normal fasting (green)
- 100–125 mg/dL: Prediabetic risk (light red)
- 126–250 mg/dL: Diabetic range (deep red)
- Over 250 mg/dL: Critical level alert (dark red)
17 Project Overview | Background Background | Process Model | Comparison Feasibility | Lessons Learnt Conclusion

# User Interface Workflow

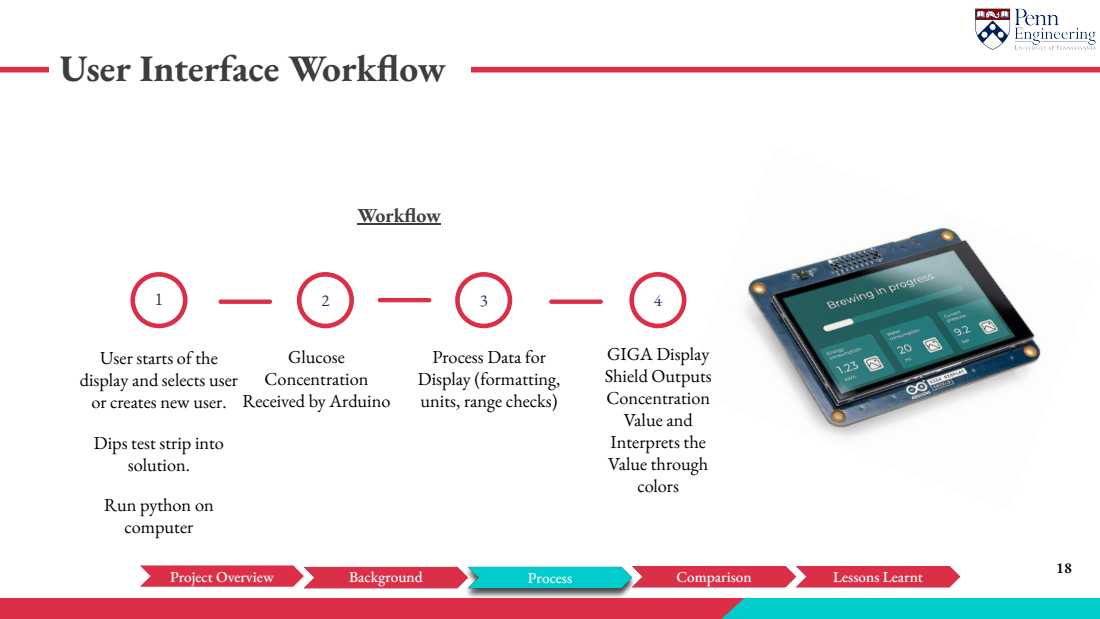
[picture p43: page 18]
18 Project Overview; Background Background; Process Model; Comparison Feasibility; Lessons Learnt Conclusion; Workflow; GIGA Display Shield Outputs Concentration Value and Interprets the Value through colors

User starts of the
display and selects user
or creates new user.
Dips test strip into
solution.
Run python on
computer

Glucose
Concentration
Received by Arduino

Process Data for
Display (formatting,
units, range checks)

# Packaging Design Process

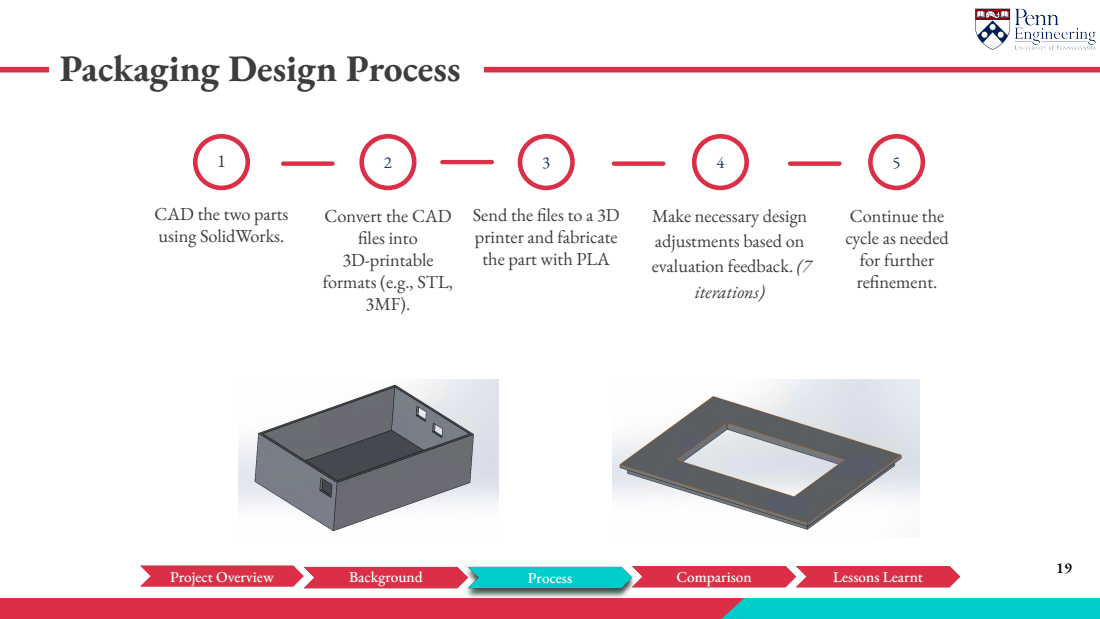
[picture p44: page 19]
19 Project Overview; Background Background; Process Model; Comparison Feasibility; Lessons Learnt Conclusion

CAD the two parts
using SolidWorks.

Convert the CAD
files into
3D-printable
formats (e.g., STL,

Send the files to a 3D
printer and fabricate
the part with PLA

Make necessary design
adjustments based on
evaluation feedback. (7
iterations)

Continue the
cycle as needed
for further
refinement.

# Comparison and Feasibility

20 Project Overview | Background | Process | Comparison | Lessons Learnt

# Cost Analysis

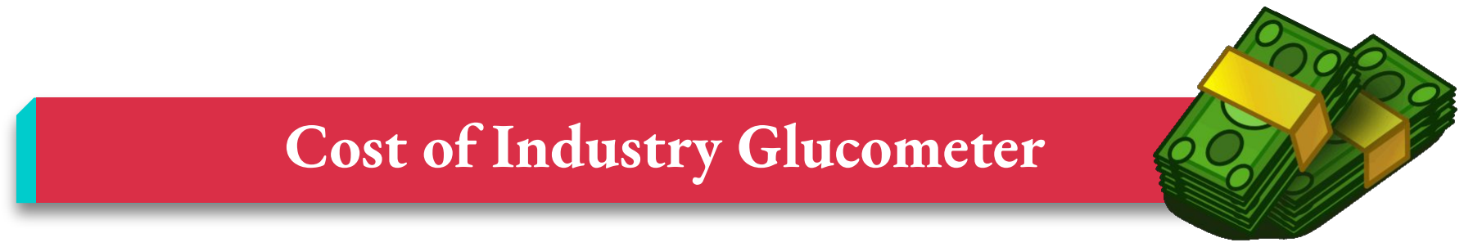
[picture p45: figure]
Cost of Industry Glucometer

Component | Cost

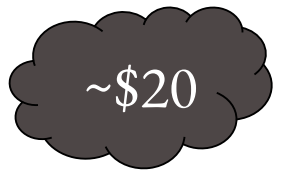
[picture p46: figure]

IO Rodeo Rodeostat | $240
Arduino Giga R1 Wifi | $73
Arduino GIGA Display Shield | $64
Wires + 3D printing estimates | $25
Needs a Laptop | $1000**
Total Cost of SweeTech | ~$402
21 Project Overview | Background | Process | Comparison | Lessons Learnt

## Clearly, we are not anywhere close to an industry standard device, but that is okay. We did learn a lot though :)

# Conclusion and Lessons Learnt

22 Project Overview | Background | Process | Comparison | Lessons Learnt

# Homemade Potentiostat Vs. IO Rodeo Potentiostat

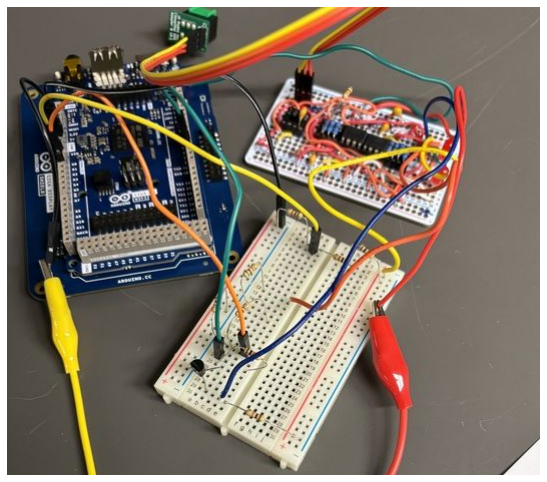
[picture p47: figure]
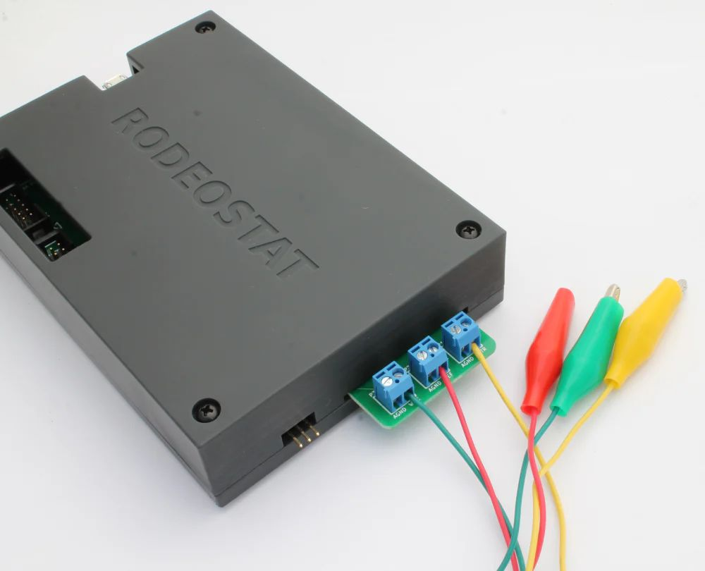
[picture p48: figure]

23 Project Overview | Background | Process | Comparison | Lessons Learnt

Vs.

# Challenges We Faced and Design Choice Workflow

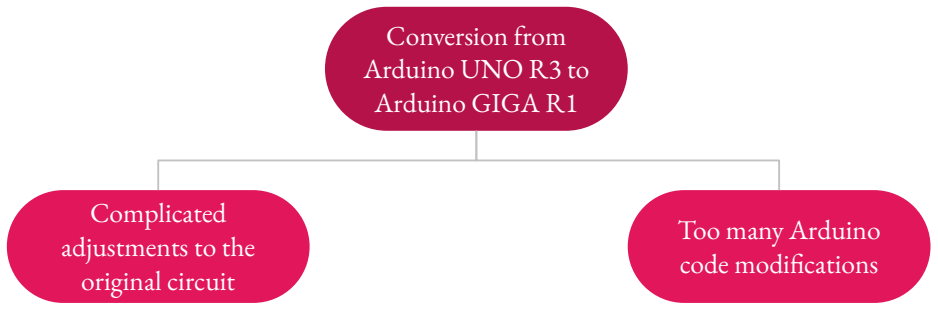
[picture p49: figure]
Conversion from Arduino UNO R3 to Arduino GIGA R1; Complicated adjustments to the original circuit; Too many Arduino code modifications

24 Project Overview | Background | Process | Comparison | Lessons Learnt

Homemade Potentiostat

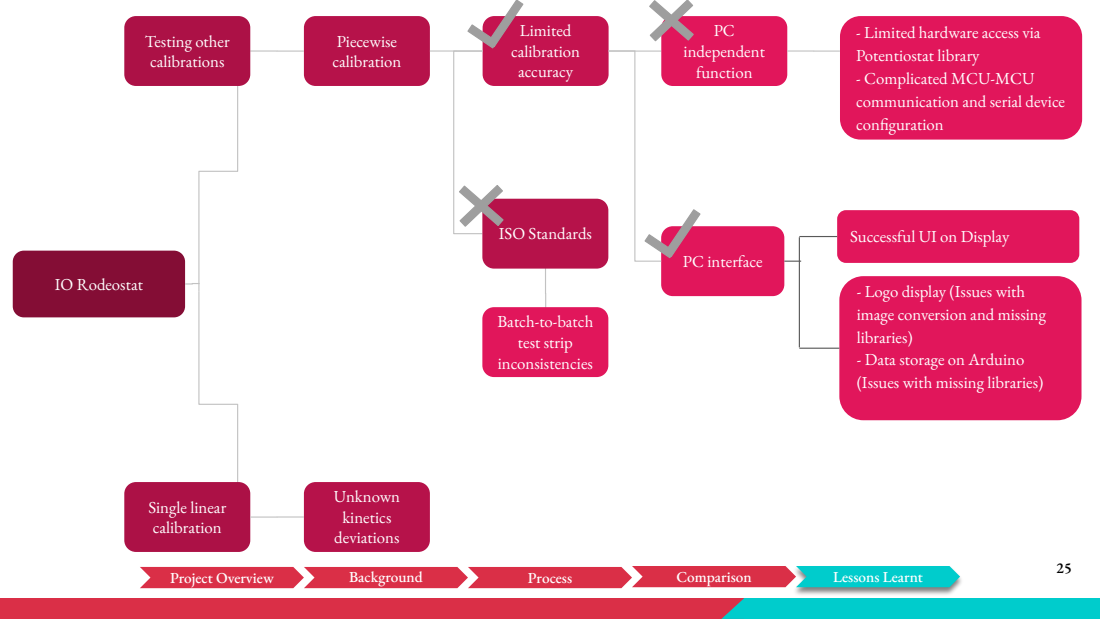
[picture p50: page 25]
25 Project Overview; Background; Process; Comparison; Lessons Learnt; IO Rodeostat; Single linear calibration; Piecewise calibration; Unknown kinetics deviations; Limited calibration accuracy; PC interface; PC independent function; ISO Standards; Testing other calibrations

- Limited hardware access via
Potentiostat library
- Complicated MCU-MCU
communication and serial device
configuration

Successful UI on Display

- Logo display (Issues with
image conversion and missing
libraries)
- Data storage on Arduino
(Issues with missing libraries)

Batch-to-batch
test strip
inconsistencies

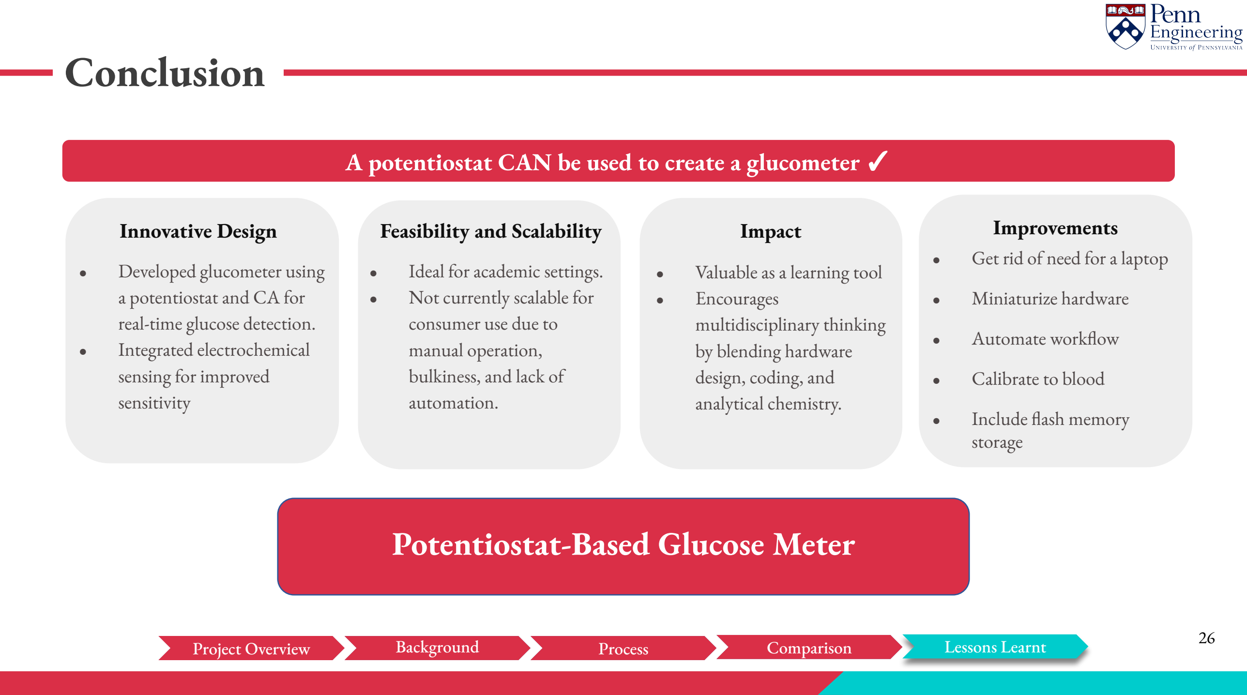
[picture p51: figure]
Conclusion; Potentiostat-Based Glucose Meter; Innovative Design; Feasibility and Scalability; Impact; Improvements; 26 Problem Problem; Background Background; Process Model; Comparison Feasibility; Lessons Learnt; ● Developed glucometer using a potentiostat and CA for real-time glucose detection. ● Integrated electrochemical sensing for improved sensitivity; ● Ideal for academic settings. ● Not currently scalable for consumer use due to manual operation, bulkiness, and lack of automation.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

A potentiostat CAN be used to create a glucometer ✓

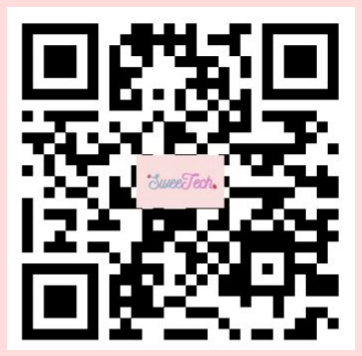
[picture p52: figure]

# Thank You!

# Any Questions?

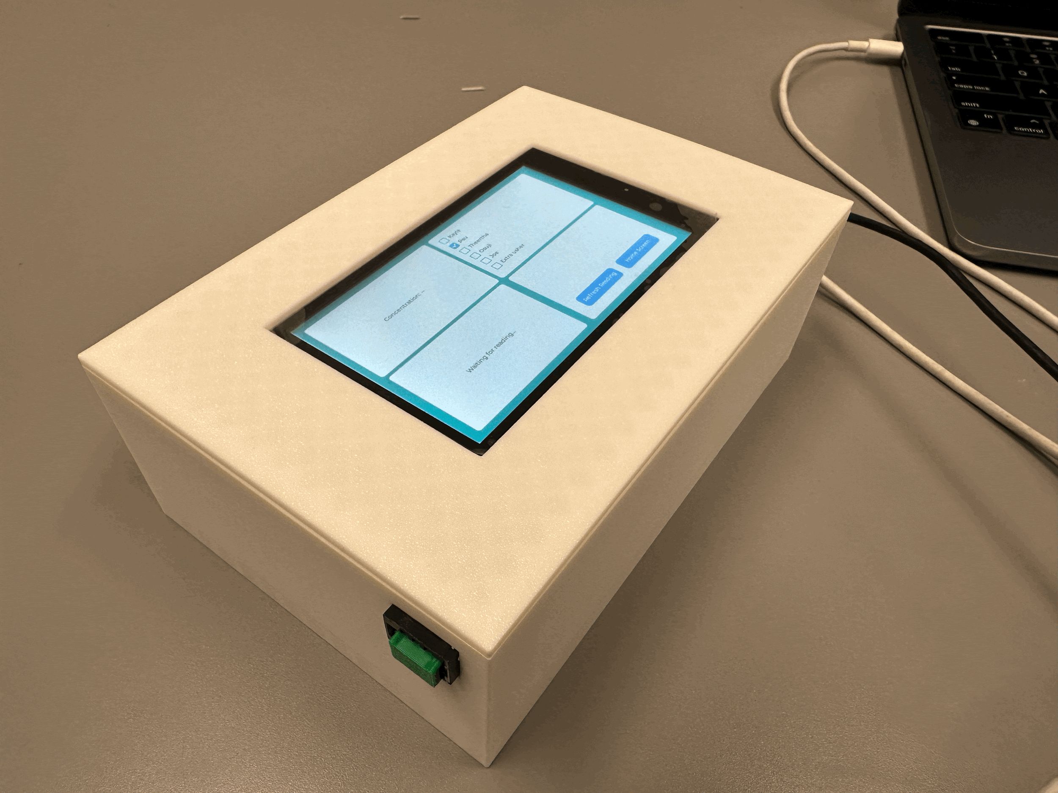
[picture p53: figure]

CBE 3300
Team SweeTech
