bpaulina25/CBE3300B/Images/CEG ref aimstrip.png

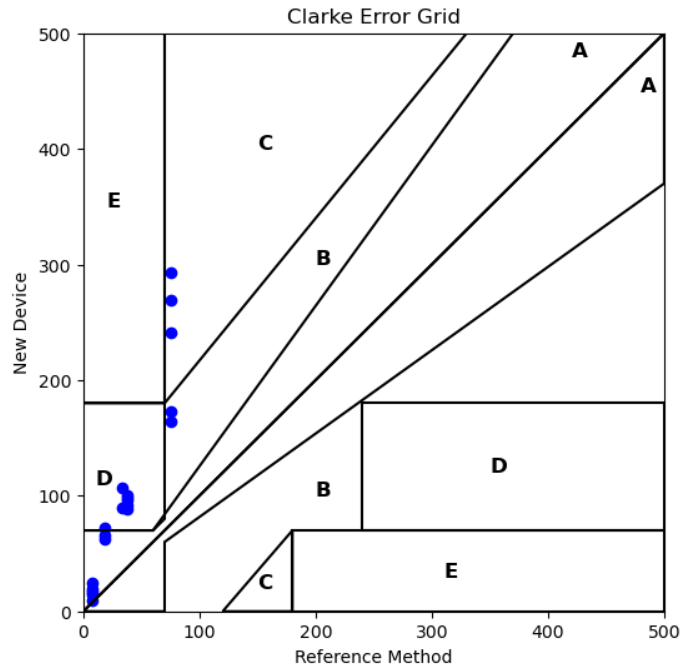
Images/CEG ref aimstrip.png
