bpaulina25/CBE3300B/Images/CEG_sort_of.png

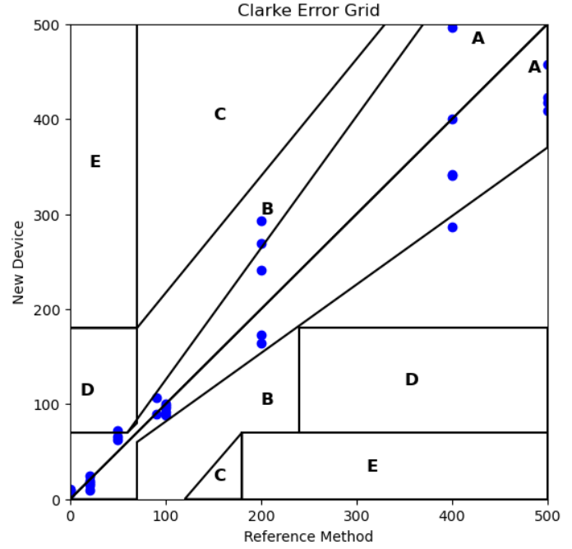
Images/CEG_sort_of.png
