bpaulina25/CBE3300B/Images/homemade_adjusted_circuit.jpg

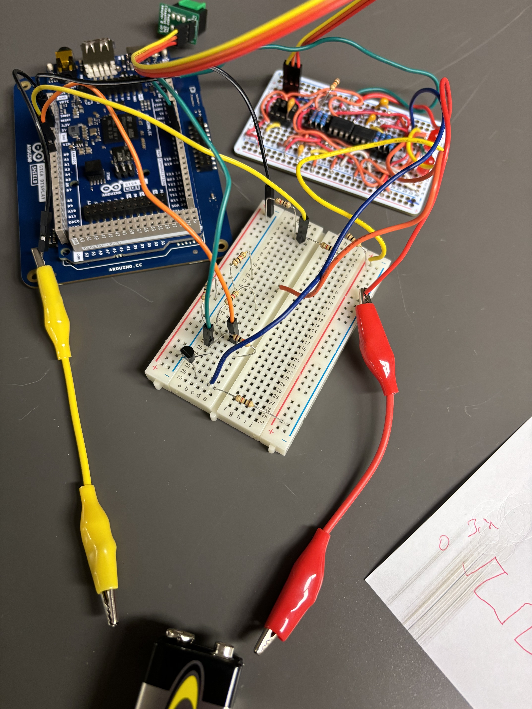
Images/homemade_adjusted_circuit.jpg
