bpaulina25/CBE3300B/Images/homemade_circuit_diagram.jpg

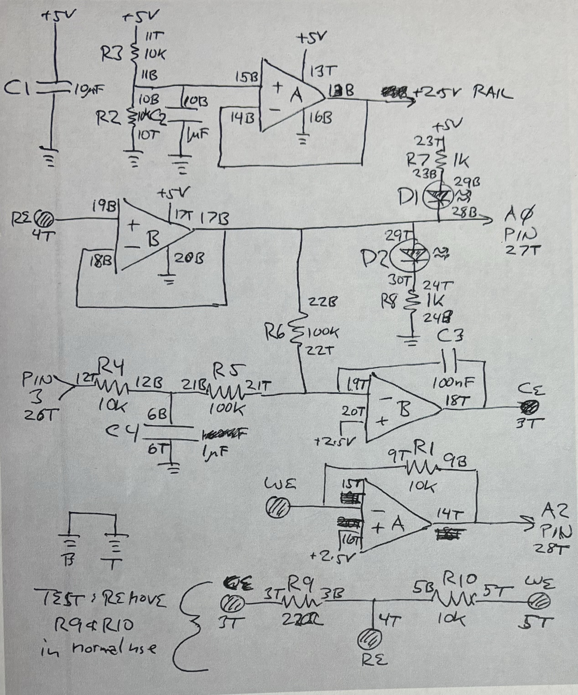
Images/homemade_circuit_diagram.jpg
