bpaulina25/CBE3300B/Images/smooth data cottrell region.png

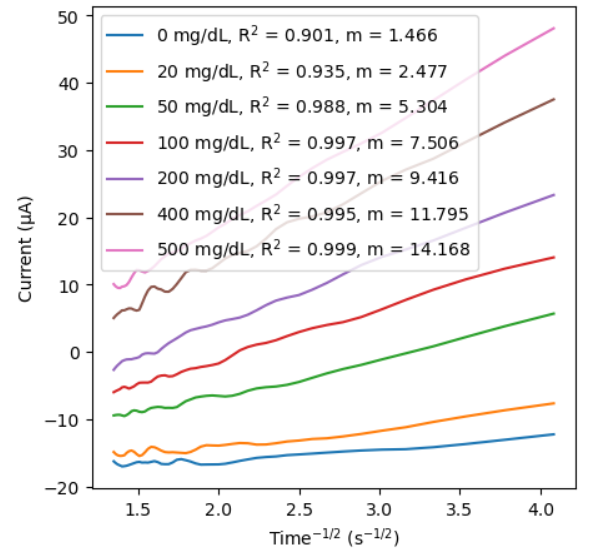
Images/smooth data cottrell region.png
