bpaulina25/CBE3300B/Images/team.jpg

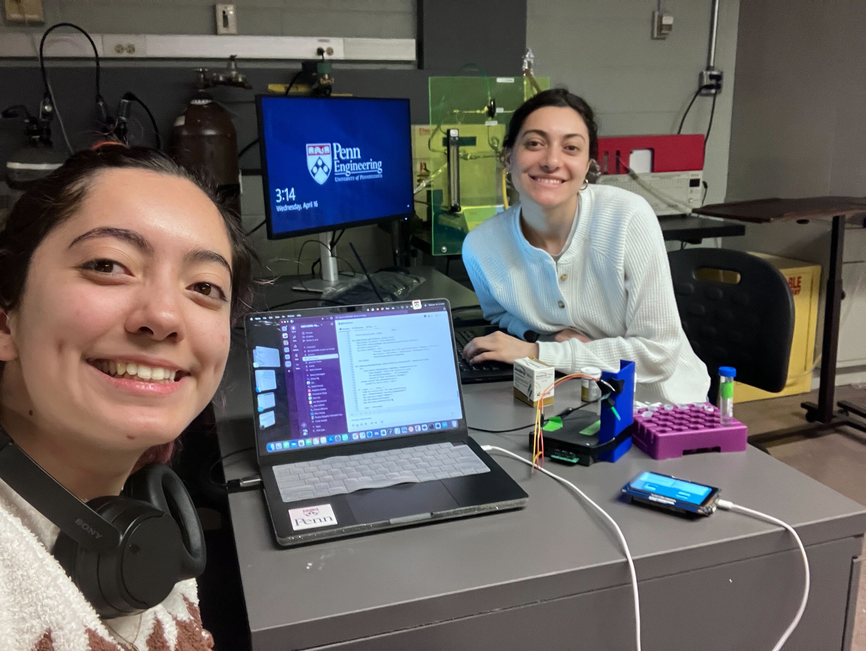
Images/team.jpg
