bpaulina25/CBE3300B/Images/window selection.png

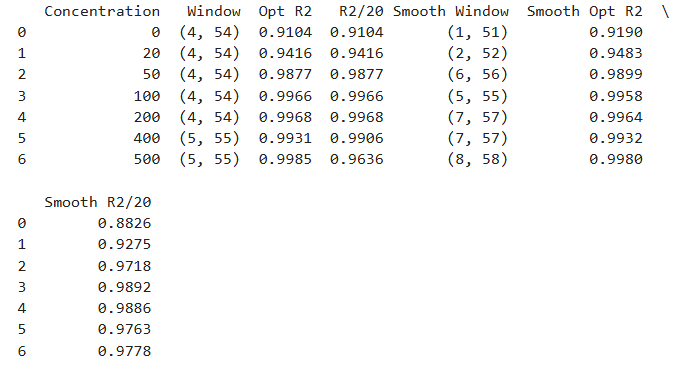
Images/window selection.png
