bpaulina25/CBE3300B/CAD_FILES/Top2.SLDPRT

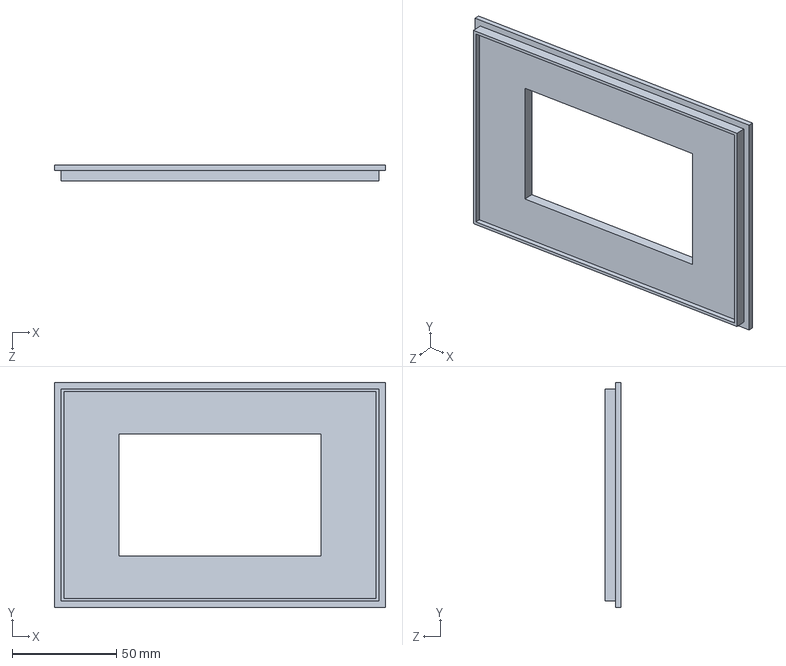
[picture p61: CAD file, 2025-04-19]
CAD_FILES/Top2.SLDPRT
158.8 x 108.0 x 7.62 mm
