bpaulina25/CBE3300B/final_resources/Bottom7.SLDPRT

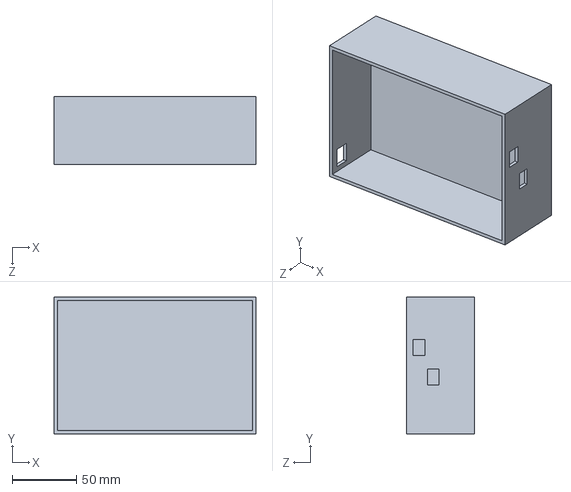
[picture p62: CAD file, 2025-05-06]
final_resources/Bottom7.SLDPRT
157.5 x 106.7 x 53.3 mm
