bpaulina25/CBE3300B/CAD_FILES/Bottom.SLDPRT

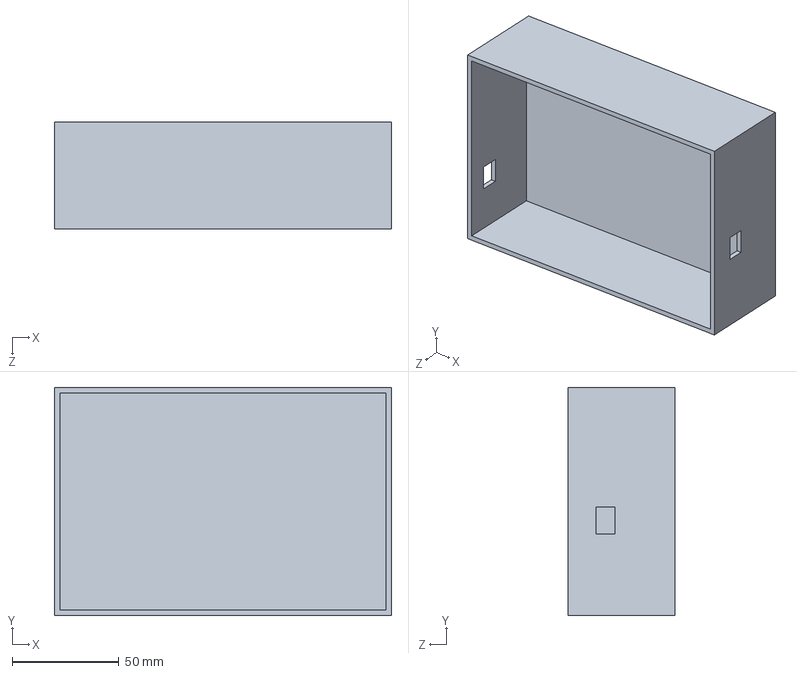
[picture p63: CAD file, 2025-04-19]
CAD_FILES/Bottom.SLDPRT
157.5 x 106.7 x 49.8 mm
