bpaulina25/CBE3300B/final_resources/Top7.SLDPRT

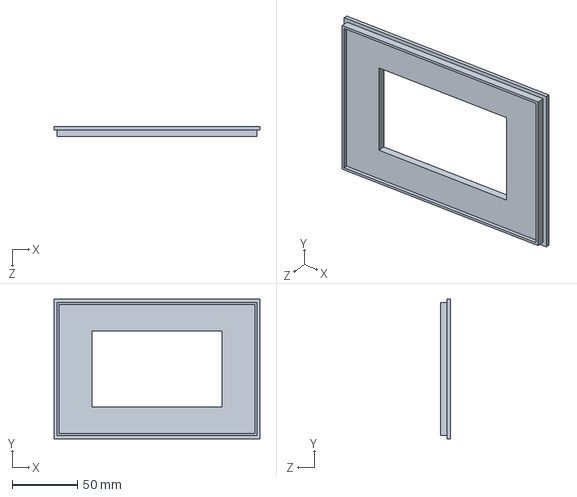
[picture p64: CAD file, 2025-05-06]
final_resources/Top7.SLDPRT
157.5 x 106.7 x 7.62 mm
