bpaulina25/CBE3300B/(list of files, cad)

Other CAD files:
CAD_FILES/Top.gcode.3mf
CAD_FILES/Bottom.gcode.3mf
CAD_FILES/Bottom.STL
CAD_FILES/Top2.STL
