bpaulina25/CBE3300B/Images/calibration.png

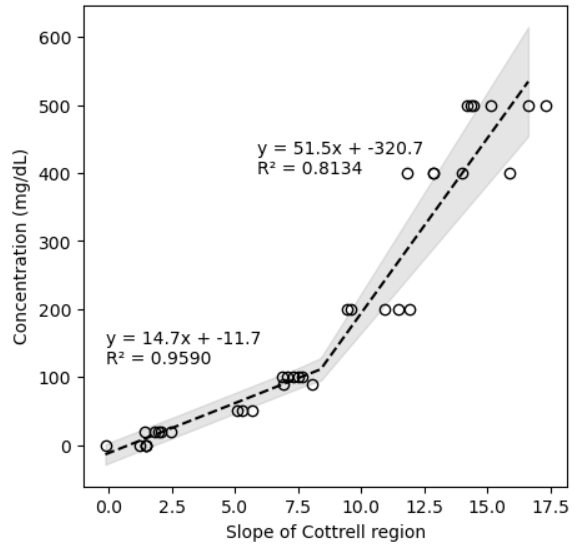
Images/calibration.png
