bpaulina25/CBE3300B/(commit log)

2025-01-30 Update index with GANTT and 3D print section.html
2025-02-20 Create arduino.html
    To store arduino codes for display
2025-02-20 Update index with arduino.html
2025-02-24 Update milestone2 with Arduino folder.html
2025-03-06 Create arduino logo
2025-03-06 Create ArduinoLogoDrawing
2025-04-07 Add files via upload
    CAD BOX
    [Bottom.gcode.3mf, Top.gcode.3mf]
2025-04-25 Potentiostat obj debugging
    Initialized the potentiostat object as a global variable; I believe it was breaking in the GUI code because the dev.() function could not reset. Now, since it is only initialized once, it supports multiples tests within the same run.
    [glucometer.py]
2025-05-06 Rename SimpleRGB.ino to arduino_codes /SimpleRGB.ino
2025-05-06 Move Bottom.SLDPRT to CAD FILES/Bottom.SLDPRT
    [Bottom.SLDPRT]
2025-05-06 MOVE Bottom.STL to CAD FILES /Bottom.STL
    [Bottom.STL]
2025-05-06 move Bottom.SLDPRT to Bottom.SLDPRT
    [Bottom.SLDPRT]
2025-05-06 Move Bottom.SLDPRT to Bottom.SLDPRT
    [Bottom.SLDPRT]
2025-05-06 Move Bottom.gcode.3mf to CAD_FILES/Bottom.gcode.3mf
    [Bottom.gcode.3mf]
2025-05-06 Move Top.gcode.3mf to CAD_FILES/Top.gcode.3mf
    [Top.gcode.3mf]
2025-05-06 Move Top2.SLDPRT to CAD_FILES/Top2.SLDPRT
    [Top2.SLDPRT]
2025-05-06 Move Top2.STL to CAD_FILES/Top2.STL
    [Top2.STL]
2025-05-06 Move test.ino to arduino_codes/test.ino
